jeong0449/FluidArdule/images/2026-06-15-fluidardule-collage.png

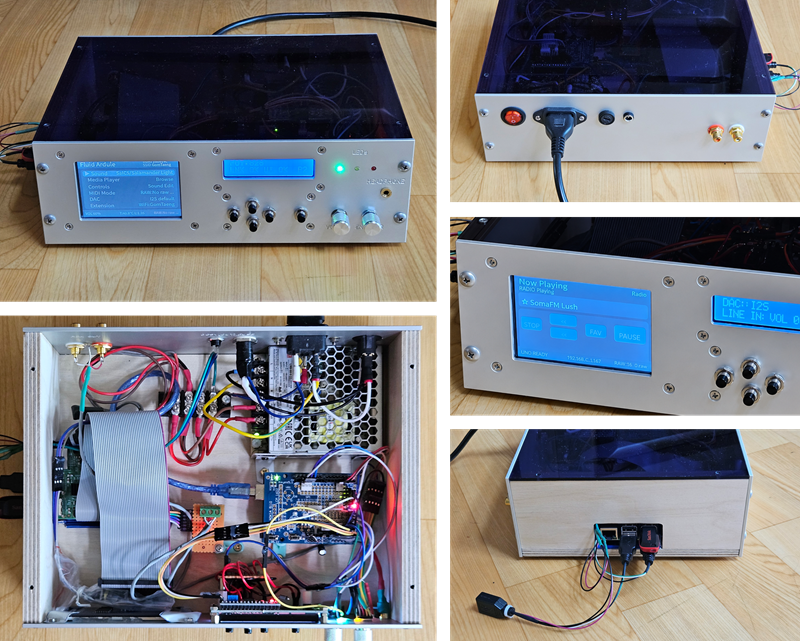
images/2026-06-15-fluidardule-collage.png
