jeong0449/FluidArdule/sf2/FluidArdule_rot.png

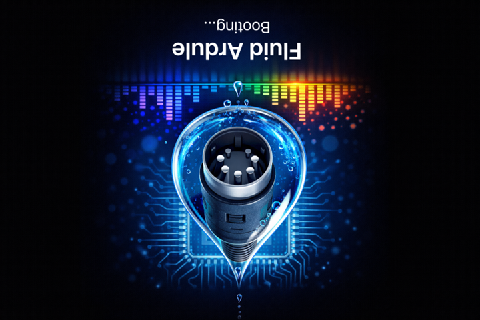
sf2/FluidArdule_rot.png
