jeong0449/FluidArdule/scripts/launch_fluidardule.py

#!/usr/bin/env python3
# -*- coding: utf-8 -*-

SCRIPT_VERSION = "260925a"

# =========================================================
# Fluid Ardule main UI/runtime script
# 260925a: Give resident Salamander C5 Lite a CH1-only Reverb default of 80;
#          show the last selected Sound Edit parameter/value on Home > Controls.
# 260924a: Standardize stacked transport navigation: NEXT above PREV in
#          Now Playing and Play with Drums; align player button actions accordingly.
# 260910e: Sound menu is a CH1 source selector again. The title bar shows
# CH2-16 resident SoundFont status at right; it dims while Yoshimi is active.
# 260910b: resident Salamander + GM SoundFont retained; Yoshimi uses reliable
#          exclusive engine handoff and restores the previous CH1 sound on return.
# Version is defined by SCRIPT_VERSION below.
# Detailed change history is tracked in Git.
# =========================================================

import os
import sys
import time
import queue
import signal
import threading
import subprocess
import re
import json
from pathlib import Path
from dataclasses import dataclass, field

import serial

try:
    from PIL import Image, ImageDraw, ImageFont, ImageChops
except Exception as exc:
    raise SystemExit(f"Pillow import failed: {exc}")



# =========================================================
# User config
# =========================================================

SERIAL_PORT = "/dev/serial/by-id/usb-Arduino__www.arduino.cc__Arduino_Uno_12724551266415469650-if00"
# Optional exact UNO-2 identifier.  If set, MIDI Mode shows
# "UNO-2 bridge (SEQ)" only when this by-id symlink exists.  Leave empty to
# fall back to detecting any additional Arduino/Uno serial device other than
# UNO-1.
UNO2_SERIAL_PORT = "/dev/serial/by-id/usb-Arduino__www.arduino.cc__0043_75834353930351211140-if00"
SERIAL_BAUD = 115200
SERIAL_TIMEOUT = 0.1
SERIAL_INPUT_IGNORE_AFTER_OPEN_SEC = 1.5
SERIAL_OUTPUT_HOLDOFF_AFTER_OPEN_SEC = 2.0

SOUNDFONTS = [
    ("/home/pi/sf2/SalC5Light2.sf2", "SalC5"),
    ("/home/pi/sf2/FluidR3_GM.sf2", "FluidR3"),
    ("/home/pi/sf2/Arachno_GM.sf2", "Arachno"),
    ("/home/pi/sf2/GeneralUser_GS.sf2", "GUserGS"),
    # Yoshimi is exposed through the same SoundFont menu as a synth-engine source.
    # The JSON file should follow Fluid Ardule instrument-list v2 and contain
    # Yoshimi .xiz entries grouped by bank_name.
    ("/home/pi/sf2/yoshimi.patches.json", "Yoshimi"),
]

# 260910a resident sound architecture
PIANO_SOUNDFONT_BASENAME = "SalC5Light2.sf2"
GM_SOUNDFONT_CHOICES = ["Arachno_GM.sf2", "FluidR3_GM.sf2", "GeneralUser_GS.sf2"]
GM_SOUNDFONT_STATE_PATH = "/home/pi/sf2/default_gm_soundfont.txt"
DEFAULT_GM_SOUNDFONT_BASENAME = "Arachno_GM.sf2"
RESIDENT_PIANO_SFID = 1
RESIDENT_GM_SFID = 2


YOSHIMI_EXECUTABLE = "yoshimi"
YOSHIMI_DEFAULT_ROOT = "/usr/share/yoshimi/banks"
YOSHIMI_PREVIEW_DEBOUNCE_SEC = 0.15
# Experimental restart-free Yoshimi instrument switching.
# When Yoshimi is already running, Fluid Ardule tries to keep the process alive
# and sends "load instrument <path>" through Yoshimi stdin.  The Yoshimi JSON
# should use space-free symlink paths because the Yoshimi CLI is fragile with
# filenames containing spaces.  If live loading is unavailable, the code falls
# back to the previous reliable restart-with -L path.
YOSHIMI_LIVE_LOAD_ENABLED = True
YOSHIMI_LIVE_LOAD_FALLBACK_RESTART = True
YOSHIMI_LIVE_LOAD_TRACE = False

# Yoshimi factory "Arpeggios" patches are not MIDI arpeggiators.
# Arpeggio1-like patches get their apparent repeat speed mainly from
# Part 1 / Effect 2 / Echo Delay.  The user-facing number below is calibrated
# to feel close to real BPM, then converted to Yoshimi Echo Delay.
ARP_BPM_DEFAULT = 120
ARP_BPM_MIN = 60
ARP_BPM_MAX = 240
ARP_BPM_STEP = 1
ARP_BPM_FINE_STEP = 1
ARP_CAL_SLOPE = 0.797
ARP_CAL_INTERCEPT = 5.13
ARP_DELAY_NUMERATOR = 6000


DEFAULT_DAC = ("default", "I2S default")
KNOWN_USB_DACS = [
    ("O22", "Onyx O22"),
    ("SCD70", "Roland SC-D70"),
    ("CODEC", "USB Audio CODEC"),
]

FLUID_GAIN = "0.4"

# Raw MIDI input selection
# 1) If RAW_MIDI_DEVICE is set, it is used directly.
# 2) Otherwise, if FIXED_MIDI_SRC is set, the first amidi -l entry whose name contains it is used.
# 3) Otherwise, preferred-name hints are tried, then the first usable raw MIDI input is used.
RAW_MIDI_DEVICE = None               # e.g. "hw:1,0,0"
RAW_MIDI_PREFERRED_HINTS = [
    "MPK Mini",
    "AKAI",
    "Keyboard",
]

# External USB MIDI interface selection.
# Match by device/client name instead of ALSA client number because client IDs
# can change across reboots or USB hotplug order changes.
EXTERNAL_MIDI_NAME_HINTS = [
    "USB Midi Cable",
    "SC-D70",
    "SCD70",
    "Roland SC-D70",
]

# Some external sound modules expose ALSA sequencer ports in both aconnect -i
# and aconnect -o. For MIDI Mode, keep only ports that can be meaningful
# performance inputs. USB MIDI cables remain visible because their DIN IN side
# can carry keyboard input; for SC-D70, show only the generic "SC-D70 MIDI"
# port and hide Part A/B, which are sound-module destinations.
SEQ_INPUT_ALLOW_EXTERNAL_HINTS = [
    "USB Midi Cable",
]
SEQ_INPUT_EXCLUDE_EXTERNAL_HINTS = [
    "SC-D70",
    "SCD70",
    "Roland SC-D70",
]
EXTERNAL_MIDI_OUT_MODES = [
    ("off", "Off"),
    ("mirror", "Mirror"),
]
EXTERNAL_MIDI_PC_PREVIEW_DEBOUNCE_SEC = 0.15

# General MIDI program names. Displayed as 001-128, sent as MIDI PC 0-127.
GM_PROGRAM_NAMES = [
    "Acoustic Grand Piano", "Bright Acoustic Piano", "Electric Grand Piano", "Honky-tonk Piano",
    "Electric Piano 1", "Electric Piano 2", "Harpsichord", "Clavi",
    "Celesta", "Glockenspiel", "Music Box", "Vibraphone",
    "Marimba", "Xylophone", "Tubular Bells", "Dulcimer",
    "Drawbar Organ", "Percussive Organ", "Rock Organ", "Church Organ",
    "Reed Organ", "Accordion", "Harmonica", "Tango Accordion",
    "Acoustic Guitar (nylon)", "Acoustic Guitar (steel)", "Electric Guitar (jazz)", "Electric Guitar (clean)",
    "Electric Guitar (muted)", "Overdriven Guitar", "Distortion Guitar", "Guitar harmonics",
    "Acoustic Bass", "Electric Bass (finger)", "Electric Bass (pick)", "Fretless Bass",
    "Slap Bass 1", "Slap Bass 2", "Synth Bass 1", "Synth Bass 2",
    "Violin", "Viola", "Cello", "Contrabass",
    "Tremolo Strings", "Pizzicato Strings", "Orchestral Harp", "Timpani",
    "String Ensemble 1", "String Ensemble 2", "SynthStrings 1", "SynthStrings 2",
    "Choir Aahs", "Voice Oohs", "Synth Voice", "Orchestra Hit",
    "Trumpet", "Trombone", "Tuba", "Muted Trumpet",
    "French Horn", "Brass Section", "SynthBrass 1", "SynthBrass 2",
    "Soprano Sax", "Alto Sax", "Tenor Sax", "Baritone Sax",
    "Oboe", "English Horn", "Bassoon", "Clarinet",
    "Piccolo", "Flute", "Recorder", "Pan Flute",
    "Blown Bottle", "Shakuhachi", "Whistle", "Ocarina",
    "Lead 1 (square)", "Lead 2 (sawtooth)", "Lead 3 (calliope)", "Lead 4 (chiff)",
    "Lead 5 (charang)", "Lead 6 (voice)", "Lead 7 (fifths)", "Lead 8 (bass + lead)",
    "Pad 1 (new age)", "Pad 2 (warm)", "Pad 3 (polysynth)", "Pad 4 (choir)",
    "Pad 5 (bowed)", "Pad 6 (metallic)", "Pad 7 (halo)", "Pad 8 (sweep)",
    "FX 1 (rain)", "FX 2 (soundtrack)", "FX 3 (crystal)", "FX 4 (atmosphere)",
    "FX 5 (brightness)", "FX 6 (goblins)", "FX 7 (echoes)", "FX 8 (sci-fi)",
    "Sitar", "Banjo", "Shamisen", "Koto",
    "Kalimba", "Bag pipe", "Fiddle", "Shanai",
    "Tinkle Bell", "Agogo", "Steel Drums", "Woodblock",
    "Taiko Drum", "Melodic Tom", "Synth Drum", "Reverse Cymbal",
    "Guitar Fret Noise", "Breath Noise", "Seashore", "Bird Tweet",
    "Telephone Ring", "Helicopter", "Applause", "Gunshot",
]

def gm_program_label(index: int) -> str:
    index = max(0, min(127, int(index)))
    return f"{index + 1:03d} {GM_PROGRAM_NAMES[index]}"


def gm_category_index_for_program(index: int) -> int:
    return max(0, min(15, int(index) // 8))


def gm_category_base(category_index: int) -> int:
    return max(0, min(15, int(category_index))) * 8


def gm_current_category_name() -> str:
    return GM_CATEGORY_NAMES[gm_category_index_for_program(state.external_midi_pc_index)]


def gm_current_category_program_indices() -> list[int]:
    base = gm_category_base(gm_category_index_for_program(state.external_midi_pc_index))
    return list(range(base, min(base + 8, len(GM_PROGRAM_NAMES))))
BRIDGE_EXECUTABLE = "/home/pi/bin/uno_midi_bridge_sp"
BRIDGE_PORT_HINT = "UNO-bridge"
BRIDGE_AUTOSTART = False
FIXED_MIDI_SRC = None
LOG_DIR = "/home/pi/log/fluidardule"
FLUID_LOG_PATH = f"{LOG_DIR}/fluidsynth.log"
PLAYER_LOG_PATH = f"{LOG_DIR}/player.log"
BLUETOOTH_APLAY_EXECUTABLE = "bluealsa-aplay"
YOSHIMI_LOG_PATH = f"{LOG_DIR}/yoshimi.log"
AMIXER_CONTROL = "PCM"
# Do not force ALSA mixer to 100% at service start.
# The first POT report from UNO-1, or the last saved pot-derived volume, owns startup volume.
FIX_VOLUME_AT_100 = False
POT_VOLUME_ENABLED = True
VOLUME_STATE_PATH = "/tmp/fluidardule_last_volume_percent"
DEFAULT_STARTUP_VOLUME_PERCENT = 85
BLUETOOTH_OUTPUT_VOLUME_PERCENT = 95
# At startup the saved/default volume is only a temporary safety value.
# The physical POT position should own the real startup volume as soon as
# UNO-1 is ready.  Some firmware builds report POT only on movement, so the
# Pi asks for a short POT snapshot window after serial connection.
POT_STARTUP_SNAPSHOT_REQUEST_SEC = 5.0
POT_STARTUP_SNAPSHOT_REQUEST_INTERVAL_SEC = 0.5
DEVICE_POLL_INTERVAL_SEC = 3.0
BLUETOOTH_STATUS_POLL_INTERVAL_SEC = 1.0
MIDI_RECONNECT_STABLE_SEC = 1.5
SERIAL_HEARTBEAT_INTERVAL_SEC = 1.0
SERIAL_UI_STATUS_INTERVAL_SEC = 1.0
SERIAL_LINK_STALE_SEC = 3.0
LED_PULSE_COOLDOWN_SEC = 0.05
POT_LED_PULSE_INTERVAL_SEC = 0.07
POT_VOLUME_PERCENT_THRESHOLD = 3
POT_LED_PERCENT_THRESHOLD = 3
SYSTEM_STATUS_POLL_INTERVAL_SEC = 10.0
BRIDGE_WATCHDOG_INTERVAL_SEC = 2.0
SERIAL_MAX_CONSEC_WRITE_ERRORS = 3
SERIAL_MAX_CONSEC_READ_ERRORS = 5
SERIAL_REOPEN_COOLDOWN_SEC = 3.0
MIDI_ACTIVITY_MONITOR_ENABLED = True
MIDI_ACTIVITY_MONITOR_POLL_SEC = 1.0


FRAMEBUFFER_DEVICE = "/dev/fb1"
FRAMEBUFFER_SYS_DIR = "/sys/class/graphics/fb1"
FALLBACK_WIDTH = 480
FALLBACK_HEIGHT = 320
BACKGROUND = (10, 12, 18)
FG = (240, 240, 240)
DIM = (160, 170, 180)
ACCENT = (100, 190, 255)
SELECT_BG = (45, 70, 110)
BOX_BG = (20, 24, 32)
STATUS_GOOD = (90, 220, 120)
STATUS_BAD = (255, 110, 110)
MODIFIED_VALUE = (255, 220, 90)
# Minimum interval between TFT renders (in seconds).
# Frequent screen updates can interfere with real-time audio on Raspberry Pi,
# causing jitter or glitches during MIDI playback.
# Increasing this value improves audio stability at the cost of UI responsiveness.
RENDER_MIN_INTERVAL = 0.10
# Diagnostic result 2026-06-20: continuous TFT rendering on Raspberry Pi 3B
# can disturb Yoshimi real-time audio. Keep normal UI responsiveness for
# FluidSynth/media, but throttle background redraws while Yoshimi is active.
YOSHIMI_RENDER_MIN_INTERVAL = 1.00
COMBI_RENDER_MIN_INTERVAL = 1.00
# During early boot, the framebuffer can be overwritten by late-starting
# splash/console components after the Python UI has already drawn Home.
# Force occasional full redraws only during this short boot window so the
# screen recovers from any external overwrite without increasing steady-state
# TFT update load.
BOOT_FULL_REDRAW_SEC = 8.0
BOOT_FULL_REDRAW_INTERVAL_SEC = 0.75
ROTATE_180 = True

FONT_CANDIDATES = [
    "/usr/share/fonts/opentype/noto/NotoSansCJK-Regular.ttc",
    "/usr/share/fonts/opentype/noto/NotoSerifCJK-Regular.ttc",
    "/usr/share/fonts/truetype/dejavu/DejaVuSans.ttf",
    "/usr/share/fonts/truetype/liberation2/LiberationSans-Regular.ttf",
    "/usr/share/fonts/truetype/noto/NotoSans-Regular.ttf",
]

# Rename editor only: fixed-width text keeps the cursor aligned with characters.
MONO_FONT_CANDIDATES = [
    "/usr/share/fonts/truetype/dejavu/DejaVuSansMono.ttf",
    "/usr/share/fonts/truetype/liberation2/LiberationMono-Regular.ttf",
    "/usr/share/fonts/truetype/noto/NotoSansMono-Regular.ttf",
]

MAIN_MENU = [
    "Sound",
    "Media Player",
    "Controls",
    "MIDI Mode",
    "DAC",
    "Extension",
]

QUICK_MENU_ITEMS = [
    "MIDI Panic",
    "Home",
    "Now Playing",
    "Sound",
    "Play with Drums",
    "USB Eject",
    "Save User Preset",
    "Arpeggio Speed",
]

FILE_ROOT_CANDIDATES = [
    "/home/pi/media",
    "/home/pi/midi",
    "/home/pi/Music",
    "/home/pi",
]

EXT_TAG = {
    ".mid": "[MID]",
    ".midi": "[MID]",
    ".wav": "[WAV]",
    ".mp3": "[MP3]",
    ".ogg": "[OGG]",
    ".wma": "[WMA]",
}

PLAYABLE_EXTS = tuple(EXT_TAG.keys())
AUDIO_FILE_EXTS = (".wav", ".mp3", ".ogg", ".wma")

FILE_MEDIA_ROOT = "/home/pi/media"
USB_MOUNT_POINT = f"{FILE_MEDIA_ROOT}/usb"
USB_STATUS_POLL_INTERVAL_SEC = 1.0
USB_EJECT_CMD = ["sudo", "-n", "/bin/umount", USB_MOUNT_POINT]
USB_LABEL = "USB"

USER_PRESET_PATH = "/home/pi/sf2/user_presets.json"
USER_COMBI_PATH = "/home/pi/sf2/user_combis.json"
COMBI_SOUNDFONT_OPTIONS = [
    ("FluidR3_GM", "FluidR3_GM.sf2"),
    ("GeneralUser_GS", "GeneralUser_GS.sf2"),
    ("Arachno_GM", "Arachno_GM.sf2"),
]
COMBI_SOUNDFONT_LABEL_COLOR = (80, 175, 235)
COMBI_INPUT_CHANNEL = 1
COMBI_PREVIEW_FOOTER_HOLD_SEC = 1.5
USER_PRESET_PREVIEW_ON_HIGHLIGHT = True
# Delay User Preset preview while scrolling so only the final highlighted item loads.
USER_PRESET_PREVIEW_DEBOUNCE_SEC = 0.45
# Larger SF2 files need a little more settling time after FluidSynth starts.
FLUIDSYNTH_STARTUP_SETTLE_DEFAULT_SEC = 1.2
FLUIDSYNTH_STARTUP_SETTLE_LARGE_SEC = 2.4
FLUIDSYNTH_LARGE_SF2_NAMES = {"FluidR3_GM.sf2", "GeneralUser_GS.sf2"}

RADIO_STATIONS_PATH = "/home/pi/sf2/radio_stations.json"
RADIO_FAVORITES_PATH = "/home/pi/sf2/radio_favorites.json"

# ADP v2.3 Final drum-pattern playback (Quick Menu > Play with Drums).
# Runtime support is intentionally ADP-only and ORN is ignored. Registered slot
# maps and the 6-accent representative velocities are resolved from JSON files
# kept beside the SoundFonts. INLINE slot maps (ID 255) are not used by this
# minimal runtime because they require parsing a companion ADT file.
ADP_PATTERN_DIR = "/home/pi/sf2/ADP"
ADP_SLOT_MAP_PATH = "/home/pi/sf2/slot_map_definitions.json"
ADP_ACCENT_LEVELS_PATH = "/home/pi/sf2/accent_levels.json"
ADP_DEFAULT_BPM = 120
ADP_DEFAULT_DRUM_VOLUME_PERCENT = 85
ADP_NOTE_LENGTH_SEC = 0.040
ADP_TAP_MIN_BPM = 40
ADP_TAP_MAX_BPM = 300
ADP_TAP_HISTORY = 5
ADP_TAP_HIHAT_NOTE = 42
ADP_TAP_HIHAT_VELOCITY = 105
ADP_TAP_HIHAT_LENGTH_SEC = 0.035
ADP_GENRES = [
    ("RCK", "Rock"),
    ("BNV", "Bossa Nova"),
    ("FNK", "Funk"),
    ("JZZ", "Jazz"),
    ("BLU", "Blues"),
    ("POP", "Pop"),
    ("BAL", "Ballad"),
    ("LAT", "Latin"),
    ("AFC", "Afro-Cuban"),
    ("SMB", "Samba"),
    ("WLZ", "Waltz"),
    ("SWG", "Swing"),
    ("SHF", "Shuffle"),
    ("REG", "Reggae"),
    ("MTL", "Metal"),
    ("HHP", "Hip-Hop"),
    ("RNB", "R&B"),
    ("EDM", "EDM"),
    ("HSE", "House"),
    ("TNO", "Techno"),
    ("DRM", "Drums"),
]
ADP_GENRE_NAME = dict(ADP_GENRES)
ADP_FIELD_NAMES = ("genre", "pattern", "kit")

WIFI_INTERFACE = "wlan0"
WPA_SUPPLICANT_CONF = "/etc/wpa_supplicant/wpa_supplicant-wlan0.conf"
WPA_SUPPLICANT_CONF_FALLBACK = "/etc/wpa_supplicant/wpa_supplicant.conf"
WIFI_SELECTED_PRIORITY = 50
WIFI_OTHER_PRIORITY = 10
# Cache Wi-Fi status/config reads to avoid repeated sudo cat during UI redraws.
WIFI_STATUS_CACHE_SEC = 10.0
WIFI_KNOWN_SSIDS_CACHE_SEC = 180.0
WIFI_SCAN_TIMEOUT_SEC = 8.0


DEFAULT_RADIO_STATIONS = [
    {"id": "somafm_groovesalad", "name": "SomaFM Groove Salad", "url": "https://ice2.somafm.com/groovesalad-128-mp3"},
    {"id": "somafm_dronezone", "name": "SomaFM Drone Zone", "url": "https://ice2.somafm.com/dronezone-128-mp3"},
    {"id": "somafm_defcon", "name": "SomaFM DEF CON", "url": "https://ice2.somafm.com/defcon-128-mp3"},
    {"id": "jazz24", "name": "Jazz24", "url": "https://live.wostreaming.net/direct/ppm-jazz24mp3-ibc1"},
    {"id": "somafm_secretagent", "name": "SomaFM Secret Agent", "url": "https://ice2.somafm.com/secretagent-128-mp3"},
    {"id": "somafm_lush", "name": "SomaFM Lush", "url": "https://ice2.somafm.com/lush-128-mp3"},
    {"id": "somafm_u80s", "name": "SomaFM Underground 80s", "url": "https://ice2.somafm.com/u80s-128-mp3"},
    {"id": "somafm_beatblender", "name": "SomaFM Beat Blender", "url": "https://ice2.somafm.com/beatblender-128-mp3"},
    {"id": "somafm_illstreet", "name": "SomaFM Illinois Street Lounge", "url": "https://ice2.somafm.com/illstreet-128-mp3"},
    {"id": "somafm_cliqhop", "name": "SomaFM Cliqhop", "url": "https://ice2.somafm.com/cliqhop-128-mp3"},
    {"id": "somafm_folkfwd", "name": "SomaFM Folk Forward", "url": "https://ice2.somafm.com/folkfwd-128-mp3"},
    {"id": "somafm_metal", "name": "SomaFM Metal Detector", "url": "https://ice2.somafm.com/metal-128-mp3"},
]
USER_PRESET_RENAME_CHARS = " ABCDEFGHIJKLMNOPQRSTUVWXYZabcdefghijklmnopqrstuvwxyz0123456789-_.,()"
USER_PRESET_RENAME_MAX_LEN = 32

POWER_MENU_ITEMS = ["Halt", "Restart Software", "Console", "Reboot"]
POWER_CONFIRM_ITEMS = ["No", "Yes"]
FLUID_ARDULE_SERVICE = "fluid_ardule.service"
RESTART_SOFTWARE_MARKER = "/tmp/fluidardule_restart_software_pending"
CONSOLE_HELPER = "/usr/local/sbin/fluidardule-console"

# Sound Edit is a volatile, non-saving performance edit page.
# CC7 Volume is intentionally excluded because the hardware pot controls volume.
SALAMANDER_REVERB_DEFAULT = 80

SOUND_EDIT_PARAMS = [
    {"label": "Expression", "name": "Expression", "cc": 11, "default": 127},
    {"label": "Modulation", "name": "Modulation", "cc": 1,  "default": 0},
    {"label": "Reverb",     "name": "Reverb",     "cc": 91, "default": 40},
    {"label": "Chorus",     "name": "Chorus",     "cc": 93, "default": 0},
    {"label": "Brightness", "name": "Brightness", "cc": 74, "default": 64},
    {"label": "Resonance",  "name": "Resonance",  "cc": 71, "default": 64},
    {"label": "Pan",        "name": "Pan",        "cc": 10, "default": 64},
    {"label": "Attack",     "name": "Attack",     "cc": 73, "default": 64},
]
SOUND_EDIT_COLS = 2
SOUND_EDIT_MIN = 0
SOUND_EDIT_MAX = 127
SOUND_EDIT_STEP = 1
# UNO-1 firmware owns low-level encoder acceleration and reports its profile via ACCEL.
# Python interprets encoder input differently depending on context:
#   - menu/list navigation: use the signed ENC magnitude from UNO as row delta
#   - Sound Edit value editing: use the signed ENC magnitude from UNO and scale it
#     non-linearly according to the current UNO acceleration profile
SOUND_EDIT_SEND_ALL_CHANNELS = True
# Keep the debug logging hooks in the code, but leave them disabled for normal use.
# Set this to True temporarily when verifying CC transmission with journalctl.
SOUND_EDIT_CC_DEBUG = False
# Encoder trace diagnostics. Enable this temporarily while running the script
# from a terminal (not as a systemd service) to see every ENC event received
# from UNO-1 and the resulting UI/value movement. Keep False for normal use.
ENCODER_TRACE = False
# Encoder acceleration profile sync diagnostics. Enable temporarily to see
# Pi -> UNO ACCELSET:n decisions when UI context changes or serial reconnects.
ACCEL_PROFILE_TRACE = True
# If True, ACCEL:n reports from UNO-1 also produce a short TFT footer message.
# Keep False for normal context-specific profile switching because UNO LCD
# already shows the active P0/P1/P2/P3 profile.
ACCEL_PROFILE_TFT_FEEDBACK = False
ENCODER_ACCEL_DEFAULT_PROFILE = 0
ENCODER_ACCEL_OPTIONS = {
    0: "P0 Precise",
    1: "P1 Fine",
    2: "P2 Normal",
    3: "P3 Fast",
}
# Pi-side default acceleration policy. UNO-1 still applies the acceleration,
# but Raspberry Pi selects the suitable profile for the current UI context.
# Long-list navigation gets P1; precise top-level/menu screens get P0;
# continuous/value editing gets P2. Unknown contexts fall back to P0.
UI_ACCEL_PROFILE_DEFAULT = 0
UI_ACCEL_PROFILE_BY_CONTEXT = {
    "main": 0,
    "file_source": 0,
    "file_browser": 1,
    "radio_browser": 1,
    "quick_menu": 0,
    "play_with_drums": 2,
    "adp_tap_tempo": 0,
    "player": 0,
    "power_menu": 0,
    "restart_wait": 0,
    "sound_edit": 2,
    "submenu:preset": 1,
    "submenu:preset_category": 1,
    "submenu:user_preset_load": 1,
    "submenu:combi_load": 1,
    "submenu:combi_detail": 1,
    "submenu:external_midi_pc": 1,
    "submenu:arp_speed": 2,
    "submenu:gm_soundfont": 0,
    "submenu:user_preset_rename": 0,
}
# Navigation jitter guard for the rotary encoder.
# UNO-1 can occasionally emit a single opposite-direction ENC event when the
# knob is turned slowly near a detent. For menu navigation, that one event is
# very visible as a wrong one-row jump, so Python ignores only a very short
# opposite-direction pulse. Sound Edit value editing is not filtered here.
ENC_NAV_REVERSAL_GUARD_SEC = 0.12
POT_MODE_DEFAULT = "VOL"
POT_MODE_FOOTER_HOLD_SEC = 1.2
ACCEL_FOOTER_HOLD_SEC = 1.2
FOOTER_ALT_INTERVAL_SEC = 2.0
VOLUME_FOOTER_HOLD_SEC = 1.8
# Soft takeover threshold for returning the physical pot to volume control.
# When POT mode switches back from PARAM to VOL, the volume is not updated
# until the physical pot position comes close to the current logical volume.
# This prevents abrupt volume jumps caused by the pot angle being reused for CC editing.
POT_VOLUME_PICKUP_THRESHOLD = 3


def default_sound_edit_values() -> dict[int, int]:
    return {int(item["cc"]): int(item["default"]) for item in SOUND_EDIT_PARAMS}


# =========================================================
# Runtime state
# =========================================================

@dataclass
class RuntimeState:
    running: bool = True

    sf_index: int = 0
    sf_name: str = ""
    gm_soundfont_basename: str = DEFAULT_GM_SOUNDFONT_BASENAME
    fluidsynth_muted: bool = False
    current_preset_bank: int = 0
    current_preset_program: int = 0
    current_preset_name: str = "Piano"
    current_engine: str = "fluidsynth"
    current_instrument_path: str | None = None
    # Snapshot of the FluidSynth CH1 sound before entering Yoshimi.
    yoshimi_restore_sf_index: int | None = None
    yoshimi_restore_bank: int = 0
    yoshimi_restore_program: int = 0
    yoshimi_restore_name: str = "Piano"

    dac_index: int = 0
    dac_name: str = DEFAULT_DAC[1]
    audio_device: str = DEFAULT_DAC[0]
    dac_options: list[tuple[str, str]] = field(default_factory=lambda: [DEFAULT_DAC])
    dac_preview_index: int = 0

    midi_mode: str = "usb_direct_raw"
    midi_mode_options: list[tuple[str, str]] = field(default_factory=lambda: [
        ("usb_direct_raw", "USB direct RAW"),
    ])
    bridge_proc: subprocess.Popen | None = None
    bridge_running: bool = False
    bridge_port_name: str = BRIDGE_PORT_HINT
    midi_display_text: str = "RAW"
    selected_alsa_input: str | None = None
    selected_alsa_input_name: str | None = None
    preferred_seq_port: str | None = None
    preferred_seq_name: str | None = None

    external_midi_out_mode: str = "off"
    external_midi_present: bool = False
    external_midi_port: str | None = None
    external_midi_name: str | None = None
    preferred_external_midi_port: str | None = None
    preferred_external_midi_name: str | None = None
    external_midi_connected: bool = False
    external_midi_pc_index: int = 0
    external_midi_pc_channel: int = 1
    arp_bpm: int = ARP_BPM_DEFAULT
    pending_external_midi_pc_index: int | None = None
    pending_external_midi_pc_due: float = 0.0

    midi_selected_name: str | None = None
    midi_options: list[tuple[str, str]] = field(default_factory=list)
    midi_src_name: str = "none"
    midi_src_port: str = "-"
    fluid_dst_port: str = "-"
    midi_connected: bool = False
    midi_pending_signature: str = ""
    midi_candidate_seen_since: float = 0.0

    fluid_pid: int | None = None
    last_event: str = "-"
    last_device_poll_time: float = 0.0
    last_render_time: float = 0.0
    dirty: bool = True
    force_full_redraw_until: float = 0.0
    last_forced_full_redraw_time: float = 0.0
    last_yoshimi_render_time: float = 0.0

    ui_mode: str = "main"      # main / submenu / file_source / file_browser / player
    menu_index: int = 0
    submenu_index: int = 0
    submenu_key: str | None = None
    # Sound submenu has two in-row choices for SoundFont/User Preset rows:
    # 0 = Default, 1 = Presets. RIGHT switches focus; SELECT chooses it.
    sound_row_focus: int = 0
    preset_entries: list[dict] = field(default_factory=list)
    preset_index: int = 0
    preset_sf_index: int | None = None
    preset_source_name: str = ""
    category_entries: list[str] = field(default_factory=list)
    category_index: int = 0
    category_source_sf_index: int | None = None
    category_source_name: str = ""
    preview_active: bool = False
    preview_restore_sf_index: int | None = None
    preview_restore_preset_bank: int = 0
    preview_restore_preset_program: int = 0
    preview_restore_preset_name: str = ""
    preview_restore_engine: str = "fluidsynth"
    preview_restore_instrument_path: str | None = None
    pending_yoshimi_preview_index: int | None = None
    pending_yoshimi_preview_due: float = 0.0

    browser_root: str = FILE_MEDIA_ROOT
    browser_path: str = FILE_MEDIA_ROOT
    browser_entries: list[dict] = field(default_factory=list)
    browser_index: int = 0
    radio_entries: list[dict] = field(default_factory=list)
    radio_index: int = 0
    radio_view_mode: str = "all"   # all / favorites

    wifi_enabled: bool = True
    wifi_current_ssid: str = ""
    wifi_ipv4_address: str = ""
    wifi_scan_results: list[str] = field(default_factory=list)
    wifi_known_ssids: list[str] = field(default_factory=list)


    player_proc_kind: str | None = None   # engine / media
    player_path: str | None = None
    player_paused: bool = False
    player_status: str = "Stopped"

    prev_ui_mode: str = "main"
    submenu_return_mode: str | None = None
    power_menu_index: int = 0
    power_confirm_action: str | None = None
    power_confirm_index: int = 0

    quick_menu_index: int = 0
    quick_resume_snapshot: dict | None = None

    sound_edit_index: int = 0
    sound_edit_values: dict[int, int] = field(default_factory=default_sound_edit_values)
    sound_edit_a_values: dict[int, int] = field(default_factory=default_sound_edit_values)
    sound_edit_active_side: str = "B"
    sound_edit_modified: set[int] = field(default_factory=set)
    sound_edit_last_adjust_time: float = 0.0
    encoder_accel_profile: int = ENCODER_ACCEL_DEFAULT_PROFILE
    encoder_accel_pending_profile: int = ENCODER_ACCEL_DEFAULT_PROFILE
    last_nav_enc_dir: int = 0
    last_nav_enc_time: float = 0.0
    pot_mode: str = POT_MODE_DEFAULT
    pot_volume_captured: bool = True
    transient_footer_text: str = ""
    transient_footer_until: float = 0.0

    volume_percent: int = 100
    last_volume_display_time: float = 0.0
    last_footer_alt_slot: int = -1
    last_pot_raw: int = -1
    initial_pot_volume_applied: bool = False
    pot_startup_request_until: float = 0.0
    last_pot_startup_request_time: float = 0.0
    last_led_pulse_time: float = 0.0
    last_pot_led_pulse_time: float = 0.0
    last_pot_led_percent: int = -1

    cpu_load_text: str = "L:-"
    cpu_temp_text: str = "T:-"
    last_system_status_poll_time: float = 0.0
    last_bridge_poll_time: float = 0.0

    usb_mounted: bool = False
    last_usb_poll_time: float = 0.0
    last_usb_autoenter_time: float = 0.0
    usb_mount_path: str = USB_MOUNT_POINT
    usb_eject_confirm: bool = False

    player_stop_requested: bool = False
    player_auto_next: bool = True
    player_origin_dir: str | None = None
    player_return_mode: str | None = None  # file_browser / radio_browser
    player_radio_station_id: str | None = None
    player_notice_text: str = ""
    player_notice_until: float = 0.0
    last_bluetooth_status_poll_time: float = 0.0
    bluetooth_stop_return_at: float = 0.0
    bluetooth_saved_volume_percent: int | None = None
    bluetooth_volume_override_active: bool = False

    adp_path: str | None = None
    adp_name: str = "No ADP pattern"
    adp_grid_code: int = 0
    adp_slot_map_id: int = 0
    adp_slot_notes: list[int] = field(default_factory=list)
    adp_accent_velocities: list[int] = field(default_factory=list)
    adp_steps: list[list[tuple[int, int]]] = field(default_factory=list)
    adp_bpm: int = ADP_DEFAULT_BPM
    adp_drum_volume_percent: int = ADP_DEFAULT_DRUM_VOLUME_PERCENT
    adp_drum_volume_captured: bool = False
    adp_playing: bool = False
    adp_error: str = ""
    adp_drum_kits: list[dict] = field(default_factory=list)
    adp_drum_kit_index: int = 0
    adp_pending_drum_kit_index: int | None = None
    adp_patterns_by_genre: dict[str, list[str]] = field(default_factory=dict)
    adp_genre_codes: list[str] = field(default_factory=list)
    adp_genre_index: int = 0
    adp_pattern_index: int = 0
    adp_selected_field: int = 0
    adp_pending_pattern: dict | None = None
    adp_source_sf_name: str = ""
    adp_source_preset_name: str = ""
    adp_tap_times: list[float] = field(default_factory=list)
    adp_tap_measured_bpm: int | None = None
    adp_tap_original_bpm: int = ADP_DEFAULT_BPM
    adp_tap_resume_playback: bool = False
    adp_tap_route_disconnected: bool = False
    # RAW MIDI devices are normally opened directly by FluidSynth and cannot be
    # monitored concurrently by amidi.  Tap Tempo temporarily restarts
    # FluidSynth with the ALSA sequencer driver so Python can own the RAW device,
    # suppress the original key notes, and interpret every Note On as a tap.

    pending_resume_after_sf_apply: bool = False

    user_preset_entries: list[dict] = field(default_factory=list)
    user_preset_target_index: int = 0
    pending_user_preset_preview_index: int | None = None
    pending_user_preset_preview_due: float = 0.0
    previewed_user_preset_index: int | None = None
    user_preset_rename_text: str = ""
    user_preset_rename_cursor: int = 0
    current_user_preset_name: str | None = None
    current_user_preset_kind: str | None = None
    combi_entries: list[dict] = field(default_factory=list)
    combi_soundfont_index: int = 0
    current_combi_id: str | None = None
    current_combi_soundfont_key: str | None = None
    current_combi_name: str | None = None
    combi_active: bool = False
    combi_parts: list[dict] = field(default_factory=list)
    combi_input_channel: int = COMBI_INPUT_CHANNEL
    combi_router_signature: str = ""
    combi_preview_active: bool = False
    combi_browse_snapshot: dict | None = None
    previewed_combi_index: int | None = None
    modal_message: str = ""
    modal_submessage: str = ""
    modal_until: float = 0.0

    # Lightweight UI caches. Sound Source rendering should not repeatedly read
    # preset JSON files on every draw; cache counts and invalidate only when the
    # underlying User Preset list is changed.
    soundfont_count_cache: dict[int, tuple[int, int]] = field(default_factory=dict)
    user_preset_count_cache: int | None = None
    user_combi_count_cache: int | None = None
    sound_source_cache_preload_started: bool = False
    sound_source_cache_preload_done: bool = False

    # Ignore short burst of stale/noisy UI events after UNO-1 serial reconnect/reset.
    serial_input_ignore_until: float = 0.0


state = RuntimeState(sf_index=0, sf_name=SOUNDFONTS[0][1])
event_q: queue.Queue[str] = queue.Queue()
fluid_proc = None
yoshimi_proc = None
fluid_log_handle = None
yoshimi_log_handle = None
player_proc = None
player_ext_midi_proc = None
player_log_handle = None
serial_handle = None
last_enc_time = 0.0
serial_lock = threading.Lock()
last_serial_hb_time = 0.0
last_serial_ui_status_time = 0.0
last_serial_ui_status_sent = ""
serial_write_error_count = 0
serial_read_error_count = 0
midi_activity_proc = None
midi_activity_signature = ""
midi_activity_thread_handle = None
combi_router_proc = None
combi_router_thread_handle = None
combi_router_generation = 0
adp_play_thread = None
adp_stop_event = threading.Event()
_wifi_status_cache_until = 0.0
_wifi_known_ssids_cache_until = 0.0
_wifi_known_ssids_cache: list[str] = []
last_accel_context_key: str | None = None
last_sent_accel_profile: int | None = None



# =========================================================
# Common utils
# =========================================================

def log(msg: str) -> None:
    ts = time.strftime("%Y-%m-%d %H:%M:%S")
    print(f"[{ts}] {msg}", flush=True)


def mark_dirty(event: str | None = None) -> None:
    if event is not None:
        state.last_event = event
    state.dirty = True


def show_footer_message(text: str, hold_sec: float = 1.2) -> None:
    """Temporarily show a high-priority status message in the footer.

    Used for short-lived hardware mode changes such as encoder acceleration
    profile and POT mode. After the hold time expires, the normal footer
    content automatically returns on the next render tick.
    """
    state.transient_footer_text = text
    state.transient_footer_until = time.time() + float(hold_sec)
    mark_dirty(text)


def show_player_notice(text: str, hold_sec: float = 1.5) -> None:
    """Temporarily show a centered notice on the Now Playing screen."""
    state.player_notice_text = str(text or "")
    state.player_notice_until = time.time() + float(hold_sec)
    mark_dirty(state.player_notice_text)


def clamp_index(index: int, length: int) -> int:
    if length <= 0:
        return 0
    if index < 0:
        return 0
    if index >= length:
        return length - 1
    return index


def run_cmd(cmd: list[str] | str) -> tuple[int, str]:
    try:
        if isinstance(cmd, str):
            p = subprocess.run(cmd, shell=True, text=True, stdout=subprocess.PIPE, stderr=subprocess.STDOUT, check=False)
        else:
            p = subprocess.run(cmd, text=True, stdout=subprocess.PIPE, stderr=subprocess.STDOUT, check=False)
        return p.returncode, p.stdout.strip()
    except Exception as exc:
        return 1, str(exc)

def get_cpu_load_text() -> str:
    try:
        load1 = os.getloadavg()[0]
        return f"L:{load1:.2f}"
    except Exception:
        return "L:-"


def get_cpu_temp_text() -> str:
    degree = "\u00B0"
    try:
        code, out = run_cmd(["vcgencmd", "measure_temp"])
        if code == 0 and "temp=" in out:
            value = out.split("temp=", 1)[1].split("'", 1)[0].strip()
            return f"T:{value}{degree}C"
    except Exception:
        pass
    try:
        raw = Path('/sys/class/thermal/thermal_zone0/temp').read_text().strip()
        return f"T:{int(raw)/1000:.1f}{degree}C"
    except Exception:
        return "T:-"


def periodic_system_status_poll() -> None:
    now = time.time()
    if now - state.last_system_status_poll_time < SYSTEM_STATUS_POLL_INTERVAL_SEC:
        return
    state.last_system_status_poll_time = now
    new_load = get_cpu_load_text()
    new_temp = get_cpu_temp_text()
    if new_load != state.cpu_load_text or new_temp != state.cpu_temp_text:
        state.cpu_load_text = new_load
        state.cpu_temp_text = new_temp
        state.dirty = True


def refresh_status_once(event: str = "Status refreshed") -> None:
    """Refresh slow-changing system/device status only on explicit user request.

    Fluid Ardule is now event-driven: normal button/encoder/POT events redraw the
    current screen, but they do not poll slow status values. UP long-press calls
    this function to update Load/Temp, MIDI/DAC/USB/Wi-Fi state, then redraw once.
    A short timed modal confirms the manual refresh using the existing popup style.
    """
    state.last_system_status_poll_time = time.time()
    state.cpu_load_text = get_cpu_load_text()
    state.cpu_temp_text = get_cpu_temp_text()
    periodic_device_poll(force=True)
    periodic_usb_poll(force=True)
    refresh_wifi_status(force=True)
    refresh_midi_display_text()
    mark_dirty(event)
    show_timed_modal_message(event, hold_sec=0.8, subtext=" ")


def force_volume_100() -> None:
    try:
        subprocess.run(["amixer", "sset", AMIXER_CONTROL, "100%"], stdout=subprocess.DEVNULL, stderr=subprocess.DEVNULL, check=False)
        state.volume_percent = 100
    except Exception:
        pass


def set_output_volume(percent: int, *, announce: bool = False) -> None:
    percent = max(0, min(100, int(percent)))
    try:
        subprocess.run(["amixer", "sset", AMIXER_CONTROL, f"{percent}%"], stdout=subprocess.DEVNULL, stderr=subprocess.DEVNULL, check=False)
        if percent != state.volume_percent:
            state.volume_percent = percent
        if announce:
            # Keep volume visible in the footer while the physical pot is being moved.
            state.last_volume_display_time = time.time()
            mark_dirty(f"Volume {percent}%")
    except Exception as exc:
        if announce:
            mark_dirty(f"Volume set failed: {exc}")


def save_volume_state(percent: int) -> None:
    try:
        Path(VOLUME_STATE_PATH).write_text(str(max(0, min(100, int(percent)))), encoding="utf-8")
    except Exception:
        pass


def load_saved_volume_state(default: int = 60) -> int:
    try:
        value = int(Path(VOLUME_STATE_PATH).read_text(encoding="utf-8").strip())
        return max(0, min(100, value))
    except Exception:
        return max(0, min(100, int(default)))


def enable_bluetooth_volume_override() -> None:
    """Use a fixed line level while Bluetooth source volume owns loudness."""
    if state.bluetooth_volume_override_active:
        return
    state.bluetooth_saved_volume_percent = int(state.volume_percent)
    state.bluetooth_volume_override_active = True
    set_output_volume(BLUETOOTH_OUTPUT_VOLUME_PERCENT, announce=False)


def restore_bluetooth_volume_override() -> None:
    """Restore the pre-Bluetooth system volume and POT ownership."""
    if not state.bluetooth_volume_override_active:
        return
    restore_percent = state.bluetooth_saved_volume_percent
    state.bluetooth_saved_volume_percent = None
    state.bluetooth_volume_override_active = False
    if restore_percent is not None:
        set_output_volume(restore_percent, announce=False)
    state.pot_volume_captured = False


def handle_pot_value(raw_value: str) -> None:
    if not POT_VOLUME_ENABLED or state.bluetooth_volume_override_active:
        return
    try:
        raw = int(raw_value)
    except ValueError:
        return
    raw = max(0, min(1023, raw))
    state.last_pot_raw = raw

    # Play with Drums can temporarily give the physical POT to CH10.  It uses
    # the same soft-takeover rule as master volume: the knob must first cross
    # the current drum level before it becomes active, preventing level jumps.
    if state.pot_mode == "DRUM" and state.ui_mode == "play_with_drums":
        percent = int(round(raw * 100 / 1023))
        if not state.adp_drum_volume_captured:
            if abs(percent - state.adp_drum_volume_percent) <= POT_VOLUME_PICKUP_THRESHOLD:
                state.adp_drum_volume_captured = True
                state.last_volume_display_time = time.time()
                mark_dirty(f"DRM {state.adp_drum_volume_percent}%")
            else:
                maybe_pulse_pot_led(percent)
                return
        if abs(percent - state.adp_drum_volume_percent) < POT_VOLUME_PERCENT_THRESHOLD:
            return
        set_adp_drum_volume(percent, announce=True)
        maybe_pulse_pot_led(percent)
        return

    # B: POT keeps volume as the default, but LEFT long can temporarily switch
    # it to PARAM mode. In PARAM mode, the full physical travel maps directly
    # to the currently highlighted Sound Edit CC value. No extra on-screen hint
    # is needed because the highlight already defines the target parameter.
    if state.pot_mode == "PARAM" and state.ui_mode == "sound_edit":
        value = clamp_cc_value(int(round(raw * SOUND_EDIT_MAX / 1023)))
        set_sound_edit_current_value_from_pot(value)
        maybe_pulse_pot_led(int(round(raw * 100 / 1023)))
        return

    percent = int(round(raw * 100 / 1023))

    # Startup volume policy 260627c:
    # Start from a fixed safe line-level value, then use soft takeover.
    # Do not let the first POT report jump the volume to an unrelated physical
    # knob position.  Volume resumes only after the pot enters the pickup range.
    if not state.initial_pot_volume_applied:
        state.initial_pot_volume_applied = True
        state.pot_startup_request_until = 0.0
        state.pot_volume_captured = False

    # Soft takeover for volume mode. If the pot has been used as a parameter
    # controller, its physical angle may no longer match the current volume.
    # When returning to VOL mode, wait until the pot is moved near the existing
    # logical volume before applying it again. This avoids sudden volume jumps.
    if not state.pot_volume_captured:
        if abs(percent - state.volume_percent) <= POT_VOLUME_PICKUP_THRESHOLD:
            state.pot_volume_captured = True
            show_timed_modal_message("Volume Active", hold_sec=0.8, subtext="Knob synchronized")
        else:
            maybe_pulse_pot_led(percent)
            return

    if abs(percent - state.volume_percent) < POT_VOLUME_PERCENT_THRESHOLD:
        return
    set_output_volume(percent, announce=True)
    save_volume_state(percent)
    maybe_pulse_pot_led(percent)

def normalize_path(path: str) -> str:
    return os.path.abspath(path)


def resolve_file_root() -> str:
    root = os.path.abspath(FILE_MEDIA_ROOT)
    os.makedirs(root, exist_ok=True)
    return root


def is_under_root(path: str, root: str) -> bool:
    try:
        return os.path.commonpath([os.path.abspath(path), os.path.abspath(root)]) == os.path.abspath(root)
    except Exception:
        return False


def find_file_root() -> str:
    for p in FILE_ROOT_CANDIDATES:
        if Path(p).exists():
            return p
    return "/home/pi"


def shorten_text(text: str, limit: int) -> str:
    text = (text or "").strip()
    if len(text) <= limit:
        return text
    if limit <= 3:
        return text[:limit]
    return text[:limit - 3] + "..."


def is_mountpoint_active(path: str) -> bool:
    return os.path.ismount(path)


def usb_status_text() -> str:
    return f"{USB_LABEL}:ON" if state.usb_mounted else f"{USB_LABEL}:---"


def get_file_source_entries() -> list[dict]:
    entries = [{"type": "source", "name": "local", "display": "Local files"}]
    if state.usb_mounted:
        entries.append({"type": "source", "name": "usb", "display": "USB drive"})
    entries.append({"type": "source", "name": "radio", "display": "Internet radio"})
    entries.append({"type": "source", "name": "bluetooth", "display": "Bluetooth audio"})
    return entries


def enter_file_source(default_usb: bool = False) -> None:
    entries = get_file_source_entries()
    state.ui_mode = "file_source"
    state.browser_index = 1 if (default_usb and len(entries) > 1) else 0
    invalidate_full_display()
    mark_dirty("File source")


def file_source_select() -> None:
    entries = get_file_source_entries()
    if not entries:
        mark_dirty("No source")
        return
    item = entries[clamp_index(state.browser_index, len(entries))]
    if item["name"] == "radio":
        enter_radio_browser()
        return
    if item["name"] == "bluetooth":
        start_bluetooth_audio_receiver()
        return
    state.browser_path = USB_MOUNT_POINT if item["name"] == "usb" else resolve_file_root()
    refresh_browser_entries()
    state.browser_index = 0
    state.ui_mode = "file_browser"
    invalidate_full_display()
    mark_dirty(item["display"])


def scan_adp_patterns() -> None:
    """Cache flat ADP files grouped by their three-letter filename prefix."""
    root = Path(ADP_PATTERN_DIR)
    grouped: dict[str, list[str]] = {}
    try:
        files = sorted(
            (p for p in root.iterdir() if p.is_file() and p.suffix.lower() == ".adp"),
            key=lambda p: p.name.lower(),
        )
    except Exception as exc:
        state.adp_error = str(exc)
        files = []

    for path in files:
        code = path.stem[:3].upper() or "DRM"
        grouped.setdefault(code, []).append(str(path))

    canonical = [code for code, _name in ADP_GENRES if code in grouped]
    unknown = sorted(code for code in grouped if code not in ADP_GENRE_NAME)
    state.adp_patterns_by_genre = grouped
    state.adp_genre_codes = canonical + unknown
    state.adp_genre_index = clamp_index(state.adp_genre_index, len(state.adp_genre_codes))
    state.adp_pattern_index = 0


def current_adp_genre_code() -> str:
    if not state.adp_genre_codes:
        return "DRM"
    return state.adp_genre_codes[clamp_index(state.adp_genre_index, len(state.adp_genre_codes))]


def current_adp_genre_name() -> str:
    code = current_adp_genre_code()
    return ADP_GENRE_NAME.get(code, code)


def current_adp_pattern_paths() -> list[str]:
    return state.adp_patterns_by_genre.get(current_adp_genre_code(), [])


def find_first_adp_file() -> Path | None:
    """Return the first cached ADP file in genre/pattern order."""
    paths = current_adp_pattern_paths()
    return Path(paths[0]) if paths else None

def crc16_ccitt(data: bytes) -> int:
    """CRC16-CCITT used by ADP v2.3 Final (poly 0x1021, init 0xFFFF)."""
    crc = 0xFFFF
    for byte in data:
        crc ^= int(byte) << 8
        for _ in range(8):
            if crc & 0x8000:
                crc = ((crc << 1) ^ 0x1021) & 0xFFFF
            else:
                crc = (crc << 1) & 0xFFFF
    return crc


def load_adp_slot_map(slot_map_id: int) -> list[int]:
    """Resolve one registered ADP slot map to representative GM MIDI notes."""
    if int(slot_map_id) == 255:
        raise ValueError("INLINE slot map is not supported by Fluid Ardule")
    try:
        maps = json.loads(Path(ADP_SLOT_MAP_PATH).read_text(encoding="utf-8"))
    except Exception as exc:
        raise ValueError(f"Cannot read slot map JSON: {exc}") from exc
    if not isinstance(maps, list):
        raise ValueError("Invalid slot map JSON: top level must be a list")
    selected = next((m for m in maps if int(m.get("slot_map_id", -1)) == int(slot_map_id)), None)
    if not isinstance(selected, dict):
        raise ValueError(f"Unknown SLOT_MAP_ID: {slot_map_id}")
    slots = selected.get("slots")
    if not isinstance(slots, list) or not slots:
        raise ValueError(f"SLOT_MAP_ID {slot_map_id} has no slots")
    ordered = sorted(slots, key=lambda item: int(item.get("slot", -1)))
    notes: list[int] = []
    for expected, item in enumerate(ordered):
        if int(item.get("slot", -1)) != expected:
            raise ValueError(f"SLOT_MAP_ID {slot_map_id} has non-contiguous slots")
        note = int(item.get("representative_midi", -1))
        if not 0 <= note <= 127:
            raise ValueError(f"SLOT_MAP_ID {slot_map_id} has invalid MIDI note")
        notes.append(note)
    if len(notes) > 16:
        raise ValueError("ADP slot map exceeds 16 slots")
    return notes


def load_adp_accent_velocities() -> list[int]:
    """Load ADP levels 0..5 from the 6-accent scheme in accent_levels.json."""
    try:
        data = json.loads(Path(ADP_ACCENT_LEVELS_PATH).read_text(encoding="utf-8"))
        levels = data["schemes"]["6-accent"]["levels"]
    except Exception as exc:
        raise ValueError(f"Cannot read 6-accent JSON: {exc}") from exc
    velocities = [None] * 6
    for item in levels:
        idx = int(item.get("index", -1))
        if 0 <= idx <= 5:
            velocity = int(item.get("representative_velocity", -1))
            if not 0 <= velocity <= 127:
                raise ValueError(f"Invalid representative velocity for accent {idx}")
            velocities[idx] = velocity
    if any(v is None for v in velocities):
        raise ValueError("6-accent JSON must define levels 0..5")
    return [int(v) for v in velocities]


def load_adp_pattern(path: str | Path) -> tuple[list[list[tuple[int, int]]], dict]:
    """Decode and validate one ADP v2.3 Final file."""
    p = Path(path)
    data = p.read_bytes()
    if len(data) < 12:
        raise ValueError("ADP header is truncated")
    if data[:4] != b"ADP3":
        raise ValueError("Unsupported ADP magic")
    version = data[4]
    if version != 23:
        raise ValueError(f"Unsupported ADP version: {version}")
    grid_code = data[5]
    if grid_code not in {0, 1, 2, 3}:
        raise ValueError(f"Unsupported ADP SUBDIV code: {grid_code}")
    step_count = data[6]
    if step_count == 0:
        raise ValueError("ADP LENGTH must not be zero")
    slot_map_id = data[7]
    payload_bytes = int.from_bytes(data[8:10], "little")
    expected_crc = int.from_bytes(data[10:12], "little")
    payload = data[12:]
    if payload_bytes != len(payload):
        raise ValueError("ADP payload length mismatch")
    actual_crc = crc16_ccitt(payload)
    if actual_crc != expected_crc:
        raise ValueError(f"ADP CRC mismatch: {actual_crc:04X}!={expected_crc:04X}")

    slot_notes = load_adp_slot_map(slot_map_id)
    accent_velocities = load_adp_accent_velocities()
    pos = 0
    steps: list[list[tuple[int, int]]] = []
    for _ in range(step_count):
        if pos >= len(payload):
            raise ValueError("ADP payload ended before all steps")
        hit_count = payload[pos]
        pos += 1
        hits: list[tuple[int, int]] = []
        seen_slots: set[int] = set()
        for _ in range(hit_count):
            if pos >= len(payload):
                raise ValueError("ADP hit data is truncated")
            packed = payload[pos]
            pos += 1
            if packed & 0x80:
                raise ValueError("ADP packed hit uses reserved bit 7")
            slot = packed >> 3
            accent = packed & 0x07
            if slot >= len(slot_notes):
                raise ValueError(f"ADP slot {slot} is outside SLOT_MAP_ID {slot_map_id}")
            if accent not in {1, 2, 3, 4, 5}:
                raise ValueError(f"Invalid ADP accent level: {accent}")
            if slot in seen_slots:
                raise ValueError(f"Duplicate ADP slot {slot} in one step")
            seen_slots.add(slot)
            hits.append((slot, accent))
        steps.append(hits)
    if pos != len(payload):
        raise ValueError("ADP payload has trailing bytes")
    return steps, {
        "grid_code": grid_code,
        "slot_map_id": slot_map_id,
        "slot_notes": slot_notes,
        "accent_velocities": accent_velocities,
        "step_count": step_count,
    }

def prepare_adp_pattern(path: str | Path) -> dict:
    steps, info = load_adp_pattern(path)
    p = Path(path)
    return {"path": str(p), "name": p.stem, "steps": steps, "info": info}


def apply_prepared_adp_pattern(prepared: dict, *, announce: bool = True) -> None:
    state.adp_path = str(prepared["path"])
    state.adp_name = str(prepared["name"])
    state.adp_steps = prepared["steps"]
    info = prepared["info"]
    state.adp_grid_code = int(info["grid_code"])
    state.adp_slot_map_id = int(info["slot_map_id"])
    state.adp_slot_notes = list(info["slot_notes"])
    state.adp_accent_velocities = list(info["accent_velocities"])
    # ADP v2.3 Final deliberately does not store tempo. Keep the user's current
    # Play with Drums tempo when browsing patterns; the page starts at 120 BPM.
    state.adp_pending_pattern = None
    if announce:
        mark_dirty(f"Pattern: {state.adp_name}")


def select_adp_pattern(path: str | Path) -> None:
    try:
        prepared = prepare_adp_pattern(path)
    except Exception as exc:
        state.adp_error = str(exc)
        mark_dirty("ADP load failed")
        return
    if state.adp_playing:
        state.adp_pending_pattern = prepared
        mark_dirty(f"Next bar: {prepared['name']}")
    else:
        apply_prepared_adp_pattern(prepared)


def move_adp_genre(delta: int) -> None:
    if not state.adp_genre_codes:
        mark_dirty("No ADP genres")
        return
    state.adp_genre_index = (state.adp_genre_index + int(delta)) % len(state.adp_genre_codes)
    state.adp_pattern_index = 0
    paths = current_adp_pattern_paths()
    if paths:
        select_adp_pattern(paths[0])


def move_adp_pattern(delta: int) -> None:
    paths = current_adp_pattern_paths()
    if not paths:
        mark_dirty("No patterns in genre")
        return
    state.adp_pattern_index = (state.adp_pattern_index + int(delta)) % len(paths)
    select_adp_pattern(paths[state.adp_pattern_index])


def cycle_adp_field() -> None:
    state.adp_selected_field = (state.adp_selected_field + 1) % len(ADP_FIELD_NAMES)
    mark_dirty(f"Select {ADP_FIELD_NAMES[state.adp_selected_field]}")


def move_adp_selected_value(delta: int) -> None:
    field_name = ADP_FIELD_NAMES[state.adp_selected_field]
    if field_name == "genre":
        move_adp_genre(delta)
    elif field_name == "pattern":
        move_adp_pattern(delta)
    else:
        move_adp_drum_kit(delta)


def adp_genre_position_label() -> str:
    total = len(state.adp_genre_codes)
    return f"[{clamp_index(state.adp_genre_index, total) + 1}/{total}]" if total else "[0/0]"


def adp_pattern_position_label() -> str:
    paths = current_adp_pattern_paths()
    total = len(paths)
    return f"[{clamp_index(state.adp_pattern_index, total) + 1}/{total}]" if total else "[0/0]"


def adp_kit_position_label(index: int | None = None) -> str:
    total = len(state.adp_drum_kits)
    if not total:
        return "[0/0]"
    idx = state.adp_drum_kit_index if index is None else int(index)
    return f"[{idx % total + 1}/{total}]"


def adp_step_interval_sec(grid_code: int, bpm: int) -> float:
    quarter = 60.0 / max(1, int(bpm))
    # ADP v2.3 Final: 16, 32, 8T, 16T = 4, 8, 3, 6 steps/quarter.
    divisor = {0: 4.0, 1: 8.0, 2: 3.0, 3: 6.0}.get(int(grid_code), 4.0)
    return quarter / divisor


def send_adp_note(slot: int, accent: int, on: bool) -> bool:
    if not (0 <= int(slot) < len(state.adp_slot_notes)):
        return False
    note = state.adp_slot_notes[int(slot)]
    if on:
        if not (1 <= int(accent) <= 5 and len(state.adp_accent_velocities) >= 6):
            return False
        velocity = state.adp_accent_velocities[int(accent)]
    else:
        velocity = 0
    command = f"noteon 9 {note} {velocity}" if on else f"noteoff 9 {note}"
    return send_fluidsynth_command(command)




def _play_adp_tap_hihat() -> None:
    """Play a short closed hi-hat without forwarding the tapped keyboard note."""
    send_fluidsynth_command(f"noteon 9 {ADP_TAP_HIHAT_NOTE} {ADP_TAP_HIHAT_VELOCITY}")

    def _off() -> None:
        time.sleep(ADP_TAP_HIHAT_LENGTH_SEC)
        send_fluidsynth_command(f"noteoff 9 {ADP_TAP_HIHAT_NOTE}")

    threading.Thread(target=_off, name="adp-tap-hihat", daemon=True).start()


def register_adp_tap(now: float | None = None) -> None:
    """Record one MIDI-key tap and update the candidate BPM."""
    if state.ui_mode != "adp_tap_tempo":
        return
    tap_time = time.monotonic() if now is None else float(now)
    if state.adp_tap_times and tap_time - state.adp_tap_times[-1] > 2.5:
        state.adp_tap_times.clear()
        state.adp_tap_measured_bpm = None
    state.adp_tap_times.append(tap_time)
    state.adp_tap_times = state.adp_tap_times[-ADP_TAP_HISTORY:]
    if len(state.adp_tap_times) >= 2:
        intervals = [b - a for a, b in zip(state.adp_tap_times, state.adp_tap_times[1:]) if b > a]
        if intervals:
            bpm = int(round(60.0 / (sum(intervals) / len(intervals))))
            state.adp_tap_measured_bpm = max(ADP_TAP_MIN_BPM, min(ADP_TAP_MAX_BPM, bpm))
    _play_adp_tap_hihat()
    mark_dirty("Tap")


def enter_adp_tap_tempo() -> None:
    """Enter Tap Tempo for ALSA Sequencer MIDI inputs only.

    USB Direct RAW is intentionally excluded.  FluidSynth owns the RAW device
    directly, and temporarily taking that device over through amidi adds enough
    process/IPC latency to make the audible tap feedback feel late.  ALSA SEQ
    inputs can be observed without restarting the engine, so their Note On
    events are used as the low-latency Tap Tempo source.
    """
    if state.midi_mode == "usb_direct_raw":
        show_timed_modal_message(
            "Tap Tempo unavailable",
            hold_sec=1.4,
            subtext="Select an ALSA MIDI mode",
        )
        return

    state.adp_tap_original_bpm = int(state.adp_bpm)
    state.adp_tap_resume_playback = bool(state.adp_playing)
    state.adp_tap_times.clear()
    state.adp_tap_measured_bpm = None
    if state.adp_playing:
        stop_adp_playback(announce=False)

    state.ui_mode = "adp_tap_tempo"
    state.adp_tap_route_disconnected = False
    if not state.combi_active:
        _disconnect_direct_midi_route()
        state.adp_tap_route_disconnected = True

    invalidate_full_display()
    mark_dirty("Tap Tempo")


def leave_adp_tap_tempo(*, apply: bool) -> None:
    """Apply/cancel the tempo, restore the ALSA MIDI route, and optionally resume."""
    if apply and state.adp_tap_measured_bpm is not None:
        state.adp_bpm = int(state.adp_tap_measured_bpm)
    else:
        state.adp_bpm = int(state.adp_tap_original_bpm)
    resume = bool(state.adp_tap_resume_playback)
    state.adp_tap_times.clear()
    state.adp_tap_measured_bpm = None
    state.adp_tap_resume_playback = False

    state.ui_mode = "play_with_drums"
    if state.adp_tap_route_disconnected:
        reconnect_midi_to_fluidsynth(force_draw=False)

    state.adp_tap_route_disconnected = False
    invalidate_full_display()
    mark_dirty("Tempo applied" if apply else "Tap canceled")
    if resume:
        start_adp_playback()

def supported_adp_soundfont() -> bool:
    """Return True for the three GM SoundFonts supported by Play with Drums."""
    try:
        base = Path(SOUNDFONTS[state.sf_index][0]).name.lower()
    except Exception:
        return False
    return base in {"fluidr3_gm.sf2", "generaluser_gs.sf2", "arachno_gm.sf2"}


def set_adp_drum_volume(percent: int, *, announce: bool = False) -> bool:
    """Set CH10 drum level with MIDI CC7 while leaving other channels unchanged."""
    percent = max(0, min(100, int(percent)))
    value = int(round(percent * 127 / 100))
    ok = send_fluidsynth_command(f"cc 9 7 {value}")
    if ok:
        state.adp_drum_volume_percent = percent
        if announce:
            # Use the common volume footer so the active POT target is obvious:
            # VOL xx% for master, DRM xx% for CH10 drum level.
            state.last_volume_display_time = time.time()
            mark_dirty(f"DRM {percent}%")
    elif announce:
        show_footer_message("Drum Volume send failed", 1.2)
    return ok


def toggle_adp_drum_pot_mode() -> None:
    """Toggle POT between master volume and CH10 drum volume with pickup."""
    if state.pot_mode == "DRUM":
        state.pot_mode = "VOL"
        state.pot_volume_captured = False
        show_footer_message(f"POT: VOL {state.volume_percent}%", POT_MODE_FOOTER_HOLD_SEC)
    else:
        state.pot_mode = "DRUM"
        state.adp_drum_volume_captured = False
        state.pot_volume_captured = False
        show_footer_message(f"POT: DRUM {state.adp_drum_volume_percent}%", POT_MODE_FOOTER_HOLD_SEC)


def load_adp_drum_kits() -> None:
    """Build the CH10 drum-kit list from the active SoundFont preset JSON."""
    kits = [p for p in load_presets_for_sf2(state.sf_index)
            if int(p.get("bank", 0)) == 128 or bool(p.get("is_drum"))]
    if not kits:
        kits = [{"name": "GM Standard", "bank": 128, "program": 0, "engine": "fluidsynth", "is_drum": True}]
    state.adp_drum_kits = kits
    state.adp_drum_kit_index = 0
    state.adp_pending_drum_kit_index = None


def adp_drum_kit_name(index: int | None = None) -> str:
    kits = state.adp_drum_kits
    if not kits:
        return "GM Standard"
    idx = state.adp_drum_kit_index if index is None else int(index)
    idx %= len(kits)
    return str(kits[idx].get("name", "Drum Kit"))


def apply_adp_drum_kit(index: int, *, announce: bool = True) -> bool:
    """Apply one SoundFont drum preset to FluidSynth CH10 only."""
    if not state.adp_drum_kits:
        return False
    idx = int(index) % len(state.adp_drum_kits)
    kit = state.adp_drum_kits[idx]
    bank = int(kit.get("bank", 128))
    program = int(kit.get("program", 0))
    ok = False
    ok = send_fluidsynth_command("drums 9 on") or ok
    ok = send_fluidsynth_command(f"bank 9 {bank}") or ok
    ok = send_fluidsynth_command(f"prog 9 {program}") or ok
    ok = send_fluidsynth_command(f"select 9 {RESIDENT_GM_SFID} {bank} {program}") or ok
    # Program/bank changes may reset channel controllers in some SoundFonts;
    # keep the user's Play with Drums balance stable across kit changes.
    set_adp_drum_volume(state.adp_drum_volume_percent, announce=False)
    state.adp_drum_kit_index = idx
    state.adp_pending_drum_kit_index = None
    if announce:
        mark_dirty(f"Drum Kit: {adp_drum_kit_name(idx)}")
    return ok


def move_adp_drum_kit(delta: int) -> None:
    """Select a drum kit; while playing, queue it for the next bar boundary."""
    if not state.adp_drum_kits:
        mark_dirty("No drum kits")
        return
    base = state.adp_pending_drum_kit_index
    if base is None:
        base = state.adp_drum_kit_index
    target = (int(base) + int(delta)) % len(state.adp_drum_kits)
    if state.adp_playing:
        state.adp_pending_drum_kit_index = target
        mark_dirty(f"Next bar: {adp_drum_kit_name(target)}")
    else:
        apply_adp_drum_kit(target)

def _adp_playback_worker() -> None:
    try:
        interval = adp_step_interval_sec(state.adp_grid_code, state.adp_bpm)
        deadline = time.monotonic()
        step_index = 0
        while not adp_stop_event.is_set() and state.adp_steps:
            # ADP has no time-signature field. For the existing 4/4 Play with
            # Drums workflow, v2.3 Final uses 16/32/8T/16T = 16/32/12/24 steps/bar.
            steps_per_bar = {0: 16, 1: 32, 2: 12, 3: 24}.get(int(state.adp_grid_code), 16)
            if step_index % steps_per_bar == 0:
                if state.adp_pending_pattern is not None:
                    apply_prepared_adp_pattern(state.adp_pending_pattern, announce=False)
                    step_index = 0
                    steps_per_bar = {0: 16, 1: 32, 2: 12, 3: 24}.get(int(state.adp_grid_code), 16)
                    mark_dirty(f"Pattern: {state.adp_name}")
                if state.adp_pending_drum_kit_index is not None:
                    apply_adp_drum_kit(state.adp_pending_drum_kit_index, announce=False)
                    mark_dirty(f"Drum Kit: {adp_drum_kit_name()}")
            interval = adp_step_interval_sec(state.adp_grid_code, state.adp_bpm)
            hits = state.adp_steps[step_index]
            active_slots = []
            for slot, accent in hits:
                if send_adp_note(slot, accent, True):
                    active_slots.append(slot)

            note_deadline = min(deadline + ADP_NOTE_LENGTH_SEC, deadline + interval)
            wait_time = note_deadline - time.monotonic()
            if wait_time > 0 and adp_stop_event.wait(wait_time):
                break
            for slot in active_slots:
                send_adp_note(slot, 0, False)

            step_index = (step_index + 1) % len(state.adp_steps)
            deadline += interval
            wait_time = deadline - time.monotonic()
            if wait_time > 0:
                if adp_stop_event.wait(wait_time):
                    break
            elif wait_time < -interval:
                # If the Pi was briefly delayed, resynchronize without adding a
                # pause at the loop boundary or rapidly replaying missed steps.
                deadline = time.monotonic()
    except Exception as exc:
        state.adp_error = str(exc)
        log(f"ADP playback failed: {exc}")
    finally:
        send_fluidsynth_command("cc 9 123 0")
        send_fluidsynth_command("cc 9 120 0")
        state.adp_playing = False
        mark_dirty("Drums stopped")


def start_adp_playback() -> None:
    global adp_play_thread
    if state.current_engine != "fluidsynth":
        show_timed_modal_message("FluidSynth required", hold_sec=1.2, subtext="ADP uses the loaded SoundFont")
        return
    if not state.adp_steps:
        show_timed_modal_message("No ADP pattern", hold_sec=1.2, subtext=state.adp_error or ADP_PATTERN_DIR)
        return
    stop_adp_playback(announce=False)
    adp_stop_event.clear()
    state.adp_playing = True
    adp_play_thread = threading.Thread(target=_adp_playback_worker, name="adp-playback", daemon=True)
    adp_play_thread.start()
    set_play_led("ON")
    mark_dirty("Drums playing")


def stop_adp_playback(*, announce: bool = True) -> None:
    global adp_play_thread
    adp_stop_event.set()
    thread = adp_play_thread
    if thread and thread.is_alive() and thread is not threading.current_thread():
        thread.join(timeout=0.5)
    adp_play_thread = None
    state.adp_playing = False
    send_fluidsynth_command("cc 9 123 0")
    send_fluidsynth_command("cc 9 120 0")
    set_play_led("OFF")
    if announce:
        mark_dirty("Drums stopped")


def enter_play_with_drums() -> None:
    stop_adp_playback(announce=False)
    state.adp_error = ""

    # Preserve an already loaded Combi.  Its CH1 keyboard routing remains
    # active while this page adds ADP drums on CH10.  Outside Combi mode,
    # automatically load GeneralUser GS when the current source is not one of
    # the supported GM SoundFonts.
    if not state.combi_active and not supported_adp_soundfont():
        apply_soundfont_with_default_preset(generaluser_soundfont_index())

    state.adp_source_sf_name = state.sf_name or "SoundFont"
    state.adp_source_preset_name = state.current_combi_name if state.combi_active else state.current_preset_name
    state.adp_selected_field = 0
    state.adp_pending_pattern = None
    state.adp_bpm = ADP_DEFAULT_BPM
    # Enter in normal master-volume mode. Drum balance is retained in runtime
    # and can be picked up explicitly with LEFT long.
    state.pot_mode = "VOL"
    state.pot_volume_captured = False
    state.adp_drum_volume_captured = False
    load_adp_drum_kits()
    apply_adp_drum_kit(0, announce=False)
    set_adp_drum_volume(state.adp_drum_volume_percent, announce=False)
    scan_adp_patterns()
    path = find_first_adp_file()
    if path is None:
        state.adp_path = None
        state.adp_name = "No ADP pattern"
        state.adp_steps = []
    else:
        try:
            apply_prepared_adp_pattern(prepare_adp_pattern(path), announce=False)
        except Exception as exc:
            state.adp_path = str(path)
            state.adp_name = path.stem
            state.adp_steps = []
            state.adp_error = str(exc)
    state.ui_mode = "play_with_drums"
    invalidate_full_display()
    mark_dirty("Play with Drums")


def leave_play_with_drums() -> None:
    stop_adp_playback(announce=False)
    if state.pot_mode == "DRUM":
        state.pot_mode = "VOL"
        state.pot_volume_captured = False
        state.adp_drum_volume_captured = False
    restore_quick_snapshot()


def toggle_adp_playback() -> None:
    if state.adp_playing:
        stop_adp_playback()
    else:
        start_adp_playback()


def ensure_radio_files_on_demand() -> None:
    """Create radio JSON files only when the Radio screen is used.

    This keeps startup/main-loop/UNO timing identical to the stable script.
    """
    sf2_dir = Path("/home/pi/sf2")
    sf2_dir.mkdir(parents=True, exist_ok=True)
    stations_path = Path(RADIO_STATIONS_PATH)
    favorites_path = Path(RADIO_FAVORITES_PATH)
    if not stations_path.exists():
        stations_path.write_text(json.dumps(DEFAULT_RADIO_STATIONS, indent=2, ensure_ascii=False) + "\n", encoding="utf-8")
    if not favorites_path.exists():
        favorites_path.write_text("[]\n", encoding="utf-8")


def load_radio_stations() -> list[dict]:
    ensure_radio_files_on_demand()
    try:
        data = json.loads(Path(RADIO_STATIONS_PATH).read_text(encoding="utf-8"))
        if not isinstance(data, list):
            data = []
    except Exception as exc:
        log(f"radio_stations.json load failed: {exc}")
        data = []

    by_id: dict[str, dict] = {}
    for item in data + DEFAULT_RADIO_STATIONS:
        if not isinstance(item, dict):
            continue
        sid = str(item.get("id") or item.get("name") or "").strip()
        name = str(item.get("name") or sid).strip()
        url = str(item.get("url") or "").strip()
        if not sid or not name or not url:
            continue
        if sid not in by_id:
            by_id[sid] = {"id": sid, "name": name, "url": url}
    return list(by_id.values())


def load_radio_favorites() -> set[str]:
    ensure_radio_files_on_demand()
    try:
        data = json.loads(Path(RADIO_FAVORITES_PATH).read_text(encoding="utf-8"))
        if isinstance(data, list):
            return {str(x).strip() for x in data if str(x).strip()}
    except Exception as exc:
        log(f"radio_favorites.json load failed: {exc}")
    return set()


def save_radio_favorites(favorites: set[str]) -> None:
    ensure_radio_files_on_demand()
    Path(RADIO_FAVORITES_PATH).write_text(json.dumps(sorted(favorites), indent=2, ensure_ascii=False) + "\n", encoding="utf-8")


def load_radio_entries_for_view(view_mode: str) -> list[dict]:
    stations = load_radio_stations()
    if view_mode == "favorites":
        favorites = load_radio_favorites()
        return [s for s in stations if str(s.get("id", "")).strip() in favorites]
    return stations


def enter_radio_browser(view_mode: str = "all", *, keep_index: bool = False) -> None:
    if view_mode not in {"all", "favorites"}:
        view_mode = "all"
    old_index = state.radio_index
    state.radio_view_mode = view_mode
    state.radio_entries = load_radio_entries_for_view(view_mode)
    state.radio_index = clamp_index(old_index if keep_index else 0, len(state.radio_entries))
    state.ui_mode = "radio_browser"
    invalidate_full_display()
    if view_mode == "favorites":
        mark_dirty(f"Radio favorites: {len(state.radio_entries)}")
    else:
        mark_dirty(f"Radio: {len(state.radio_entries)} stations")


def current_radio_station() -> dict | None:
    if radio_index_is_favorites_entry():
        return None
    if not state.radio_entries:
        return None
    return state.radio_entries[clamp_index(radio_station_index(), len(state.radio_entries))]


def radio_display_labels() -> list[str]:
    favorites = load_radio_favorites()
    labels = []
    if state.radio_view_mode == "all":
        labels.append("★ Favorites")
    for station in state.radio_entries:
        star = "★ " if str(station.get("id", "")) in favorites else "  "
        labels.append(star + str(station.get("name", "Radio")))
    return labels


def radio_index_is_favorites_entry() -> bool:
    return state.radio_view_mode == "all" and state.radio_index == 0


def radio_station_index() -> int:
    return state.radio_index - 1 if state.radio_view_mode == "all" else state.radio_index


def find_radio_station_by_id(station_id: str | None) -> dict | None:
    sid = str(station_id or "").strip()
    if not sid:
        return None
    for station in load_radio_stations():
        if str(station.get("id", "")).strip() == sid:
            return station
    return None


def toggle_current_radio_favorite() -> None:
    station = current_radio_station()
    if not station:
        mark_dirty("No station")
        return
    sid = str(station.get("id", "")).strip()
    if not sid:
        mark_dirty("No station id")
        return
    favorites = load_radio_favorites()
    if sid in favorites:
        favorites.remove(sid)
        msg = "Favorite removed"
    else:
        favorites.add(sid)
        msg = "Favorite added"
    save_radio_favorites(favorites)
    if state.radio_view_mode == "favorites":
        old_index = state.radio_index
        state.radio_entries = load_radio_entries_for_view("favorites")
        state.radio_index = clamp_index(old_index, len(state.radio_entries))
    invalidate_full_display()
    mark_dirty(msg)

def toggle_radio_favorite_by_id(station_id: str | None, station_name: str | None = None) -> None:
    """Toggle favorite for the currently playing radio station.

    Player mode does not necessarily have a valid radio_browser selection, so
    do not rely on current_radio_station() here.
    This is used by the RIGHT/Favorite button while Internet radio is playing.
    """
    sid = str(station_id or "").strip()
    if not sid:
        mark_dirty("No station id")
        return

    # Resolve a human-readable name only for status text.  Do not require the
    # station list to be available; the station id is the authoritative key.
    name = str(station_name or "").strip()
    if not name:
        station = find_radio_station_by_id(sid)
        if station:
            name = str(station.get("name", "")).strip()

    favorites = load_radio_favorites()
    if sid in favorites:
        favorites.remove(sid)
        msg = "Favorite removed"
    else:
        favorites.add(sid)
        msg = "Favorite added"
    save_radio_favorites(favorites)

    # Keep the favorites view coherent if the user returns there immediately.
    if state.radio_view_mode == "favorites":
        old_index = state.radio_index
        state.radio_entries = load_radio_entries_for_view("favorites")
        state.radio_index = clamp_index(old_index, len(state.radio_entries))

    invalidate_full_display()
    if name:
        mark_dirty(f"{msg}: {shorten_text(name, 18)}")
    else:
        mark_dirty(msg)



def play_adjacent_radio_station(delta: int) -> None:
    """Move to the previous/next station while Internet radio is playing.

    This mirrors file playback's adjacent-item behavior, but uses the active
    radio view (all/favorites) and does not wrap at either end.
    """
    if state.player_proc_kind != "radio" and state.player_return_mode != "radio_browser":
        mark_dirty("Radio not active")
        return

    if not state.radio_entries:
        state.radio_entries = load_radio_entries_for_view(state.radio_view_mode)
    if not state.radio_entries:
        show_player_notice("No stations")
        return

    current_id = str(state.player_radio_station_id or "").strip()
    current_pos = None
    if current_id:
        for i, station in enumerate(state.radio_entries):
            if str(station.get("id", "")).strip() == current_id:
                current_pos = i
                break

    if current_pos is None:
        # Fall back to the browser selection.  In the all-stations view the
        # first display row is "Favorites", so convert the display index back
        # to a station index.
        current_pos = radio_station_index() if state.radio_view_mode == "all" else state.radio_index
        current_pos = clamp_index(current_pos, len(state.radio_entries))

    next_pos = current_pos + int(delta)
    if next_pos < 0:
        show_player_notice("First station")
        return
    if next_pos >= len(state.radio_entries):
        show_player_notice("Last station")
        return

    state.radio_index = next_pos + (1 if state.radio_view_mode == "all" else 0)
    station = state.radio_entries[next_pos]
    log(f"RADIO adjacent delta={delta} next={station.get('name','Radio')}")
    start_radio_station(station)

def start_radio_station(station: dict) -> None:
    url = str(station.get("url", "")).strip()
    name = str(station.get("name", "Radio")).strip() or "Radio"
    if not url:
        mark_dirty("No radio URL")
        return

    send_ui_status("BUSY", force=True)
    global player_proc
    stop_player_only()
    stop_fluidsynth()

    audio = state.audio_device
    mpv_audio = "alsa/default" if audio == "default" else f"alsa/{audio}"
    cmd = [
        "mpv",
        "--no-video",
        "--really-quiet",
        "--no-terminal",
        "--idle=no",
        f"--audio-device={mpv_audio}",
        url,
    ]

    show_modal_message("Connecting radio...", shorten_text(name, 24))
    log(f"RADIO cmd={' '.join(cmd)}")
    log_handle = open_player_log()
    try:
        player_proc = subprocess.Popen(cmd, stdout=log_handle, stderr=log_handle, preexec_fn=os.setsid, text=True)
    except FileNotFoundError:
        restart_engine(state.sf_index, state.dac_index, manage_modal=False)
        clear_modal_message()
        mark_dirty("mpv missing")
        send_ui_status("READY", force=True)
        return
    except Exception as exc:
        restart_engine(state.sf_index, state.dac_index)
        clear_modal_message()
        mark_dirty(f"Radio failed: {exc}")
        send_ui_status("READY", force=True)
        return

    state.player_path = name
    state.player_proc_kind = "radio"
    state.player_paused = False
    state.player_status = "Playing"
    state.player_stop_requested = False
    state.player_origin_dir = None
    state.player_return_mode = "radio_browser"
    state.player_radio_station_id = str(station.get("id", "")).strip() or None
    state.ui_mode = "player"
    invalidate_full_display()
    set_play_led("ON")
    clear_modal_message()
    mark_dirty(f"Radio: {name}")
    send_ui_status("READY", force=True)



def _bluetoothctl_lines(*commands: str) -> tuple[int, str]:
    """Run a short bluetoothctl command sequence non-interactively."""
    if not commands:
        return 1, ""
    payload = "\n".join(str(cmd).strip() for cmd in commands if str(cmd).strip()) + "\n"
    try:
        proc = subprocess.run(
            ["bluetoothctl", "--timeout", "3"],
            input=payload,
            text=True,
            stdout=subprocess.PIPE,
            stderr=subprocess.STDOUT,
            check=False,
            timeout=5.0,
        )
        return proc.returncode, proc.stdout.strip()
    except Exception as exc:
        return 1, str(exc)


def bluetooth_connected_device() -> tuple[str | None, str | None]:
    """Return (MAC, display name) for the currently connected device only.

    Trusted devices that are not connected are intentionally ignored. Bluetooth
    pairing/trust remains a Console/SSH concern; the player screen reports only
    the device that is actually connected now.
    """
    code, out = run_cmd(["bluetoothctl", "--timeout", "3", "devices", "Connected"])
    if code != 0 or not out:
        return None, None
    for line in out.splitlines():
        match = re.match(r"^Device\s+([0-9A-Fa-f:]{17})\s+(.+)$", line.strip())
        if not match:
            continue
        mac = match.group(1)
        fallback_name = match.group(2).strip()
        info_code, info_out = run_cmd(["bluetoothctl", "--timeout", "3", "info", mac])
        if info_code == 0 and info_out:
            alias = re.search(r"^\s*Alias:\s*(.+)$", info_out, flags=re.M)
            name = re.search(r"^\s*Name:\s*(.+)$", info_out, flags=re.M)
            if alias and alias.group(1).strip():
                return mac, alias.group(1).strip()
            if name and name.group(1).strip():
                return mac, name.group(1).strip()
        return mac, fallback_name or "Bluetooth device"
    return None, None


def bluetooth_streaming_active(mac: str | None) -> bool:
    """Best-effort BlueALSA streaming-state check.

    BlueALSA versions differ in CLI detail output. When an explicit running or
    active flag is unavailable, the UI safely remains at Connected.
    """
    if not mac:
        return False
    code, out = run_cmd(["bluealsa-cli", "list-pcms"])
    if code != 0 or not out:
        return False
    mac_compact = mac.replace(":", "_").lower()
    candidates = [line.strip() for line in out.splitlines() if mac.lower() in line.lower() or mac_compact in line.lower()]
    for pcm in candidates:
        info_code, info_out = run_cmd(["bluealsa-cli", "info", pcm])
        if info_code == 0 and re.search(r"^\s*(?:Running|Active):\s*(?:true|yes|1)\s*$", info_out, flags=re.I | re.M):
            return True
    return False


def periodic_bluetooth_status_poll() -> None:
    """Refresh the Bluetooth Audio screen only while receiver mode is active."""
    if state.player_proc_kind != "bluetooth" or state.ui_mode != "player":
        return
    now = time.time()
    if now - state.last_bluetooth_status_poll_time < BLUETOOTH_STATUS_POLL_INTERVAL_SEC:
        return
    state.last_bluetooth_status_poll_time = now

    mac, name = bluetooth_connected_device()
    new_path = name or "Waiting for device..."
    if mac:
        new_status = "Streaming" if bluetooth_streaming_active(mac) else "Connected"
    else:
        new_status = "Waiting"

    if new_path != state.player_path or new_status != state.player_status:
        state.player_path = new_path
        state.player_status = new_status
        mark_dirty("Bluetooth status")


def start_bluetooth_audio_receiver() -> None:
    """Enter exclusive Bluetooth A2DP receiver mode using BlueALSA.

    Pairing and trust management remain manual Console/SSH operations.
    This mode intentionally stops the internal synth engine and does not mix
    Bluetooth audio with live keyboard sound.
    """
    global player_proc
    send_ui_status("BUSY", force=True)
    show_modal_message("Starting Bluetooth...", "Waiting for paired device")

    stop_player_only()
    stop_fluidsynth()
    enable_bluetooth_volume_override()

    cmd = [BLUETOOTH_APLAY_EXECUTABLE, "-D", state.audio_device]
    log(f"BLUETOOTH cmd={' '.join(cmd)}")
    log_handle = open_player_log()
    try:
        player_proc = subprocess.Popen(
            cmd,
            stdout=log_handle,
            stderr=log_handle,
            preexec_fn=os.setsid,
            text=True,
        )
        time.sleep(0.2)
        if player_proc.poll() is not None:
            raise RuntimeError("bluealsa-aplay exited immediately")
    except FileNotFoundError:
        player_proc = None
        restore_bluetooth_volume_override()
        restart_engine(state.sf_index, state.dac_index, manage_modal=False)
        restore_current_preset_after_engine_restart()
        clear_modal_message()
        mark_dirty("bluealsa-aplay missing")
        send_ui_status("READY", force=True)
        return
    except Exception as exc:
        player_proc = None
        restore_bluetooth_volume_override()
        restart_engine(state.sf_index, state.dac_index, manage_modal=False)
        restore_current_preset_after_engine_restart()
        clear_modal_message()
        mark_dirty(f"Bluetooth failed: {exc}")
        send_ui_status("READY", force=True)
        return

    state.player_path = "Waiting for device..."
    state.player_proc_kind = "bluetooth"
    state.player_paused = False
    state.player_status = "Waiting"
    state.player_stop_requested = False
    state.player_origin_dir = None
    state.player_return_mode = "file_source"
    state.player_radio_station_id = None
    state.ui_mode = "player"
    invalidate_full_display()
    set_play_led("ON")
    clear_modal_message()
    mark_dirty("Bluetooth receiver active")
    send_ui_status("READY", force=True)


# =========================================================
# Wi-Fi helpers
# =========================================================

def wifi_conf_paths() -> list[str]:
    """Return existing wpa_supplicant config paths, wlan0-specific first.

    Raspberry Pi OS may run wpa_supplicant@wlan0 with
    /etc/wpa_supplicant/wpa_supplicant-wlan0.conf, while older setups use
    /etc/wpa_supplicant/wpa_supplicant.conf.  Keep both in sync when both
    exist, but prefer the wlan0-specific file for reading.
    """
    paths: list[str] = []
    for p in (WPA_SUPPLICANT_CONF, WPA_SUPPLICANT_CONF_FALLBACK):
        if p and p not in paths and Path(p).exists():
            paths.append(p)
    if not paths:
        paths.append(WPA_SUPPLICANT_CONF)
    return paths


def read_wifi_conf_text(path: str) -> str:
    """Read a root-protected wpa_supplicant config safely.

    The config is normally 600 root:root. Fluid Ardule usually runs as the
    pi user, so direct open() may fail even though systemd can use the file.
    Try normal read first, then fall back to sudo cat with non-interactive
    sudo. This keeps the main Python process non-root.
    """
    try:
        return Path(path).read_text(encoding="utf-8", errors="ignore")
    except PermissionError:
        code, out = run_cmd(["sudo", "-n", "cat", path])
        if code == 0:
            return out
        log(f"Wi-Fi config sudo read failed ({path}): {out}")
        return ""
    except Exception as exc:
        log(f"Wi-Fi config read failed ({path}): {exc}")
        return ""


def _decode_wpa_quoted_ssid(value: str) -> str:
    """Decode only wpa_supplicant backslash escapes without corrupting UTF-8 SSIDs."""
    value = str(value or "")
    value = value.replace(r"\\", "\0")
    value = value.replace(r'\"', '"')
    value = value.replace(r"\n", "\n").replace(r"\r", "\r").replace(r"\t", "\t")
    return value.replace("\0", "\\")


def parse_wpa_supplicant_networks(conf_path: str | None = None, *, force: bool = False) -> list[str]:
    """Return the union of configured SSIDs from the available wpa_supplicant files."""
    global _wifi_known_ssids_cache_until, _wifi_known_ssids_cache
    now = time.time()
    if conf_path is None and not force and now < _wifi_known_ssids_cache_until:
        return list(_wifi_known_ssids_cache)

    paths = [conf_path] if conf_path else wifi_conf_paths()
    ssids: list[str] = []

    for path in paths:
        text = read_wifi_conf_text(path)
        if not text:
            continue
        for block in re.findall(r'network\s*=\s*\{(.*?)\}', text, flags=re.S):
            m = re.search(r'^\s*ssid\s*=\s*"((?:\\.|[^"\\])*)"', block, flags=re.M)
            if not m:
                continue
            ssid = _decode_wpa_quoted_ssid(m.group(1))
            if ssid and ssid not in ssids:
                ssids.append(ssid)

    if conf_path is None:
        _wifi_known_ssids_cache = list(ssids)
        _wifi_known_ssids_cache_until = now + WIFI_KNOWN_SSIDS_CACHE_SEC
    return ssids


def wifi_is_enabled() -> bool:
    code, out = run_cmd(["rfkill", "list", "wifi"])
    if code == 0 and out:
        return "Soft blocked: yes" not in out
    return Path(f"/sys/class/net/{WIFI_INTERFACE}").exists()


def wifi_current_ssid() -> str:
    code, out = run_cmd(["iwgetid", WIFI_INTERFACE, "-r"])
    if code == 0 and out.strip():
        return out.strip()

    # Robust fallback when wireless-tools reports nothing although iw sees a link.
    code, out = run_cmd(["iw", "dev", WIFI_INTERFACE, "link"])
    if code == 0 and out:
        m = re.search(r"^\s*SSID:\s*(.+?)\s*$", out, flags=re.M)
        if m:
            return m.group(1).strip()
    return ""


def wifi_ipv4_address() -> str:
    """Return the DHCP-assigned IPv4 address of the Wi-Fi interface."""
    code, out = run_cmd(["ip", "-4", "-o", "addr", "show", "dev", WIFI_INTERFACE, "scope", "global"])
    if code != 0 or not out:
        return ""
    match = re.search(r"\binet\s+(\d+(?:\.\d+){3})/\d+", out)
    return match.group(1) if match else ""


def refresh_wifi_status(*, force: bool = False) -> None:
    """Refresh Wi-Fi status with a short cache for UI redraw safety."""
    global _wifi_status_cache_until
    now = time.time()
    if not force and now < _wifi_status_cache_until:
        return
    state.wifi_enabled = wifi_is_enabled()
    state.wifi_current_ssid = wifi_current_ssid() if state.wifi_enabled else ""
    state.wifi_ipv4_address = wifi_ipv4_address() if state.wifi_current_ssid else ""
    state.wifi_known_ssids = parse_wpa_supplicant_networks(force=force)
    _wifi_status_cache_until = now + WIFI_STATUS_CACHE_SEC


def wifi_status_label(*, short: bool = False) -> str:
    refresh_wifi_status()
    if not state.wifi_enabled:
        return "Off"
    if state.wifi_current_ssid:
        if state.wifi_ipv4_address:
            return (
                f"{state.wifi_current_ssid}: {state.wifi_ipv4_address}"
                if short
                else f"Connected: {state.wifi_current_ssid} / {state.wifi_ipv4_address}"
            )
        return state.wifi_current_ssid if short else f"Connected: {state.wifi_current_ssid}"
    return "On" if short else "On / not connected"


def restart_wifi_services() -> bool:
    """Restart OS-managed Wi-Fi services and let priority choose the AP."""
    ok = True
    commands = [
        ["sudo", "-n", "systemctl", "restart", f"wpa_supplicant@{WIFI_INTERFACE}"],
        ["sudo", "-n", "systemctl", "restart", "dhcpcd"],
    ]
    for cmd in commands:
        code, out = run_cmd(cmd)
        if code != 0:
            ok = False
            log(f"Wi-Fi service command failed: {' '.join(cmd)} :: {out}")
    return ok


def set_wifi_enabled(enabled: bool) -> bool:
    if enabled:
        run_cmd(["sudo", "-n", "rfkill", "unblock", "wifi"])
        run_cmd(["sudo", "-n", "ip", "link", "set", WIFI_INTERFACE, "up"])
        restart_wifi_services()
    else:
        run_cmd(["sudo", "-n", "rfkill", "block", "wifi"])
    refresh_wifi_status(force=True)
    return state.wifi_enabled == enabled


def _collect_ssids_from_scan_output(out: str, detected: set[str]) -> None:
    """Accept output from iw, iwlist, or wpa_cli scan_results."""
    if not out:
        return
    for line in out.splitlines():
        stripped = line.strip()
        if stripped.startswith("SSID: "):
            ssid = stripped.split("SSID: ", 1)[1].strip()
            if ssid:
                detected.add(ssid)
    for ssid in re.findall(r'ESSID:"(.*?)"', out):
        if ssid:
            detected.add(ssid)
    # wpa_cli scan_results: bssid / frequency / signal / flags / ssid
    for line in out.splitlines():
        if "\t" not in line or line.lower().startswith("bssid"):
            continue
        parts = line.split("\t", 4)
        if len(parts) == 5 and parts[4].strip():
            detected.add(parts[4].strip())


def scan_wifi_ssids() -> list[str]:
    """Return configured SSIDs that are currently visible.

    Try multiple scan paths because an associated wlan0 may reject one scanner
    while another still has useful results. The current SSID is always retained.
    """
    known = parse_wpa_supplicant_networks(force=True)
    state.wifi_known_ssids = known
    if not wifi_is_enabled():
        state.wifi_scan_results = []
        refresh_wifi_status(force=True)
        return []

    detected: set[str] = set()
    current = wifi_current_ssid()
    if current:
        detected.add(current)

    scan_commands = [
        ["sudo", "-n", "iw", "dev", WIFI_INTERFACE, "scan"],
        ["sudo", "-n", "iwlist", WIFI_INTERFACE, "scan"],
        ["sudo", "-n", "wpa_cli", "-i", WIFI_INTERFACE, "scan_results"],
    ]
    for cmd in scan_commands:
        try:
            p = subprocess.run(
                cmd,
                text=True,
                stdout=subprocess.PIPE,
                stderr=subprocess.STDOUT,
                check=False,
                timeout=WIFI_SCAN_TIMEOUT_SEC,
            )
            if p.returncode == 0:
                _collect_ssids_from_scan_output(p.stdout or "", detected)
        except (subprocess.TimeoutExpired, FileNotFoundError):
            continue
        except Exception as exc:
            log(f"Wi-Fi scan failed ({' '.join(cmd)}): {exc}")

    visible_known = [ssid for ssid in known if ssid in detected]
    # Never hide the active configured network just because an active scan failed.
    if current in known and current not in visible_known:
        visible_known.insert(0, current)

    state.wifi_scan_results = visible_known
    refresh_wifi_status(force=True)
    return visible_known


def update_priorities_in_wpa_text(text: str, selected_ssid: str) -> tuple[str, bool]:
    """Return config text with selected_ssid priority raised."""
    changed = False

    def repl(match: re.Match) -> str:
        nonlocal changed
        block = match.group(0)
        body = match.group(1)
        m = re.search(r'^\s*ssid\s*=\s*"((?:\\.|[^"\\])*)"', body, flags=re.M)
        if not m:
            return block
        ssid = _decode_wpa_quoted_ssid(m.group(1))
        if not ssid:
            return block
        priority = WIFI_SELECTED_PRIORITY if ssid == selected_ssid else WIFI_OTHER_PRIORITY
        new_line = f"        priority={priority}"
        if re.search(r'^\s*priority\s*=.*$', body, flags=re.M):
            new_body = re.sub(r'^\s*priority\s*=.*$', new_line, body, count=1, flags=re.M)
        else:
            # Insert before the closing brace while preserving the existing block.
            new_body = body.rstrip() + "\n" + new_line + "\n"
        new_block = "network={" + new_body + "}"
        if new_block != block:
            changed = True
        return new_block

    new_text = re.sub(r'network\s*=\s*\{(.*?)\}', repl, text, flags=re.S)
    return new_text, changed


def write_text_with_sudo(path: str, text: str) -> bool:
    tmp = f"/tmp/fluidardule-{Path(path).name}"
    try:
        Path(tmp).write_text(text, encoding="utf-8")
    except Exception as exc:
        log(f"Wi-Fi temp config write failed: {exc}")
        return False
    code, out = run_cmd(["sudo", "-n", "install", "-m", "600", "-o", "root", "-g", "root", tmp, path])
    try:
        Path(tmp).unlink(missing_ok=True)
    except Exception:
        pass
    if code != 0:
        log(f"Wi-Fi config install failed ({path}): {out}")
        return False
    return True


def set_wifi_priority_for_ssid(ssid: str) -> bool:
    """Raise selected SSID priority in existing config files."""
    ok_any = False
    for path in wifi_conf_paths():
        text = read_wifi_conf_text(path)
        if not text:
            continue
        new_text, changed = update_priorities_in_wpa_text(text, ssid)
        if not changed:
            ok_any = True
            continue
        if write_text_with_sudo(path, new_text):
            ok_any = True
            # Config changed; force the next read to see the new priorities.
            global _wifi_known_ssids_cache_until, _wifi_status_cache_until
            _wifi_known_ssids_cache_until = 0.0
            _wifi_status_cache_until = 0.0
    return ok_any


def wait_for_wifi_connection(ssid: str, timeout_sec: float = 15.0) -> bool:
    """Wait until the selected SSID becomes the active association."""
    deadline = time.time() + float(timeout_sec)
    while time.time() < deadline:
        refresh_wifi_status(force=True)
        if state.wifi_current_ssid == ssid:
            return True
        time.sleep(0.75)
    refresh_wifi_status(force=True)
    return state.wifi_current_ssid == ssid


def connect_wifi_ssid(ssid: str) -> bool:
    """Select Wi-Fi by rewriting priority and restarting OS Wi-Fi services.

    This intentionally avoids wpa_cli select_network because this Fluid Ardule
    image already connects reliably at boot using wpa_supplicant priority, even
    when the wpa_cli control socket is unavailable.
    """
    ssid = str(ssid or "").strip()
    if not ssid:
        return False
    if ssid not in parse_wpa_supplicant_networks(force=True):
        mark_dirty("Wi-Fi network not configured")
        return False

    # Hotfix 2026-05-27:
    # If the selected SSID is already connected, do not rewrite priority or
    # restart Wi-Fi services. A service restart can briefly disturb USB/serial
    # timing on the Raspberry Pi and may make UNO-1 appear disconnected.
    refresh_wifi_status(force=True)
    if state.wifi_enabled and state.wifi_current_ssid == ssid:
        mark_dirty(f"Already connected: {ssid}")
        return True

    if not wifi_is_enabled():
        set_wifi_enabled(True)
        refresh_wifi_status(force=True)
        if state.wifi_enabled and state.wifi_current_ssid == ssid:
            mark_dirty(f"Already connected: {ssid}")
            return True

    if not set_wifi_priority_for_ssid(ssid):
        mark_dirty("Wi-Fi config update failed")
        return False

    show_modal_message("Switching Wi-Fi...", shorten_text(ssid, 24))
    send_ui_status("BUSY", force=True)
    services_ok = restart_wifi_services()
    ok = wait_for_wifi_connection(ssid, timeout_sec=15.0)
    clear_modal_message()
    send_ui_status("READY", force=True)
    if not ok:
        log(f"Wi-Fi priority switch timeout for {ssid}; current={state.wifi_current_ssid or '-'}; services_ok={services_ok}")
    return ok


def wifi_menu_options() -> list[tuple[str, bool]]:
    refresh_wifi_status()
    rows = [(f"Wi-Fi: {'On' if state.wifi_enabled else 'Off'}", state.wifi_enabled)]
    rows.append(("Scan known networks", False))
    if state.wifi_scan_results:
        rows.extend((f"    {ssid}", ssid == state.wifi_current_ssid)
                    for ssid in state.wifi_scan_results)
    else:
        rows.append(("No configured network found", False))
    return rows

# =========================================================
# Raw MIDI discovery
# =========================================================

_RAW_AMIDI_RE = re.compile(r'^(?P<dir>[IO]{1,2})\s+(?P<port>hw:\d+,\d+,\d+)\s+(?P<name>.+?)\s*$')


def list_raw_midi_inputs() -> list[tuple[str, str]]:
    code, out = run_cmd(["amidi", "-l"])
    if code != 0 or not out:
        return []

    entries: list[tuple[str, str]] = []
    for line in out.splitlines():
        line = line.strip()
        if not line or line.lower().startswith("dir"):
            continue
        m = _RAW_AMIDI_RE.match(line)
        if not m:
            continue
        direction = m.group("dir")
        port = m.group("port")
        name = m.group("name").strip()
        if "I" not in direction:
            continue
        entries.append((port, name))
    return entries


def choose_raw_midi_input() -> tuple[str | None, str | None]:
    entries = list_raw_midi_inputs()
    if not entries:
        return None, None

    if RAW_MIDI_DEVICE:
        for port, name in entries:
            if port == RAW_MIDI_DEVICE:
                return port, name
        return RAW_MIDI_DEVICE, RAW_MIDI_DEVICE

    preferred_terms: list[str] = []
    if FIXED_MIDI_SRC:
        preferred_terms.append(FIXED_MIDI_SRC)
    preferred_terms.extend(RAW_MIDI_PREFERRED_HINTS)

    for term in preferred_terms:
        term_lower = term.lower()
        for port, name in entries:
            if term_lower in name.lower() or term_lower in port.lower():
                return port, name

    return entries[0]


def list_raw_midi_outputs() -> list[tuple[str, str]]:
    code, out = run_cmd(["amidi", "-l"])
    if code != 0 or not out:
        return []

    entries: list[tuple[str, str]] = []
    for line in out.splitlines():
        line = line.strip()
        if not line or line.lower().startswith("dir"):
            continue
        m = _RAW_AMIDI_RE.match(line)
        if not m:
            continue
        direction = m.group("dir")
        port = m.group("port")
        name = m.group("name").strip()
        if "O" not in direction:
            continue
        entries.append((port, name))
    return entries


def find_external_midi_raw_output() -> tuple[str | None, str | None]:
    for port, name in list_raw_midi_outputs():
        text = f"{port} {name}".lower()
        if any(hint.lower() in text for hint in EXTERNAL_MIDI_NAME_HINTS):
            return port, name
    return None, None


# =========================================================
# Serial tx helpers
# =========================================================


def send_serial_line(line: str) -> bool:
    global serial_handle, serial_write_error_count
    data = (line.rstrip("\n") + "\n").encode("ascii", errors="ignore")
    with serial_lock:
        if serial_handle is None:
            return False
        try:
            serial_handle.write(data)
            serial_handle.flush()
            serial_write_error_count = 0
            return True
        except Exception as exc:
            serial_write_error_count += 1
            log(f"serial write failed ({serial_write_error_count}/{SERIAL_MAX_CONSEC_WRITE_ERRORS}): {exc}")
            if serial_write_error_count >= SERIAL_MAX_CONSEC_WRITE_ERRORS:
                log("serial write error threshold reached; forcing reconnect")
                try:
                    serial_handle.close()
                except Exception:
                    pass
                serial_handle = None
                serial_write_error_count = 0
            return False


def periodic_serial_heartbeat() -> None:
    global last_serial_hb_time
    now = time.time()
    if now - last_serial_hb_time < SERIAL_HEARTBEAT_INTERVAL_SEC:
        return
    if send_serial_line("HB"):
        last_serial_hb_time = now


def current_ui_link_status() -> str:
    # LINK/HB means the Pi process is alive. UI status means the main loop is
    # intentionally able to accept UNO control events. Keep playback itself
    # READY; reserve BUSY for modal/system operations where input should not be
    # trusted or may be delayed.
    if state.ui_mode == "restart_wait":
        return "BUSY"
    if state.ui_mode == "power_menu" and state.power_confirm_action in {"EXEC_HALT", "EXEC_REBOOT", "EXEC_RESTART_SOFTWARE"}:
        return "BUSY"
    if state.usb_eject_confirm:
        return "BUSY"
    return "READY"


def send_ui_status(status: str, *, force: bool = False) -> bool:
    global last_serial_ui_status_time, last_serial_ui_status_sent
    status = status.strip().upper()
    if status not in {"READY", "BUSY"}:
        status = "READY"
    now = time.time()
    if (not force) and status == last_serial_ui_status_sent and (now - last_serial_ui_status_time) < SERIAL_UI_STATUS_INTERVAL_SEC:
        return False
    if send_serial_line(f"UI:{status}"):
        last_serial_ui_status_sent = status
        last_serial_ui_status_time = now
        return True
    return False


def periodic_serial_ui_status() -> None:
    send_ui_status(current_ui_link_status())


def encoder_accel_context_key() -> str:
    """Return a compact key for Pi-selected encoder acceleration policy."""
    if state.ui_mode == "submenu":
        return f"submenu:{state.submenu_key or ''}"
    return str(state.ui_mode or "main")


def desired_encoder_accel_profile() -> int:
    """Choose the default encoder acceleration profile for the current UI."""
    key = encoder_accel_context_key()
    profile = UI_ACCEL_PROFILE_BY_CONTEXT.get(key, UI_ACCEL_PROFILE_DEFAULT)
    try:
        return max(0, min(3, int(profile)))
    except Exception:
        return UI_ACCEL_PROFILE_DEFAULT


def sync_encoder_accel_profile(*, force: bool = False, reason: str = "") -> None:
    """Send the UI-context-specific acceleration profile to UNO-1.

    UNO-1 owns the low-level encoder acceleration and displays the active
    P0/P1/P2/P3 profile on its LCD.  The Pi only selects the desired profile
    for the current UI context and sends ACCELSET:n when the context changes
    or after serial reconnect.
    """
    global last_accel_context_key, last_sent_accel_profile
    if serial_handle is None:
        return
    key = encoder_accel_context_key()
    profile = desired_encoder_accel_profile()
    if (not force) and key == last_accel_context_key and profile == last_sent_accel_profile:
        return
    if send_serial_line(f"ACCELSET:{profile}"):
        last_accel_context_key = key
        last_sent_accel_profile = profile
        state.encoder_accel_profile = profile
        state.encoder_accel_pending_profile = profile
        if ACCEL_PROFILE_TRACE:
            suffix = f" reason={reason}" if reason else ""
            log(f"ACCEL_PROFILE ui={key} -> P{profile}{suffix}")


def request_startup_pot_snapshot_window() -> None:
    """Ask UNO-1 to report the physical POT position soon after serial opens.

    This keeps startup volume owned by the knob, not by the saved/default
    fallback.  Older UNO firmware may ignore REQ:POT; in that case this is
    harmless, and normal POT movement still works.
    """
    now = time.time()
    state.pot_startup_request_until = now + POT_STARTUP_SNAPSHOT_REQUEST_SEC
    state.last_pot_startup_request_time = 0.0


def periodic_startup_pot_snapshot_request() -> None:
    if state.initial_pot_volume_applied:
        return
    now = time.time()
    if now > state.pot_startup_request_until:
        return
    if now - state.last_pot_startup_request_time < POT_STARTUP_SNAPSHOT_REQUEST_INTERVAL_SEC:
        return
    state.last_pot_startup_request_time = now
    send_serial_line("REQ:POT")


def ack_uno_event(kind: str) -> None:
    kind = kind.strip().upper()
    if kind in {"BTN", "ENC"}:
        send_serial_line(f"ACK:{kind}")


def pulse_midi_led() -> None:
    send_serial_line("ACT:MIDI")


def maybe_pulse_led(min_interval_sec: float = LED_PULSE_COOLDOWN_SEC, *, force: bool = False) -> None:
    now = time.time()
    if (not force) and (now - state.last_led_pulse_time) < min_interval_sec:
        return
    state.last_led_pulse_time = now
    pulse_midi_led()


def maybe_pulse_pot_led(current_percent: int) -> None:
    now = time.time()
    if state.last_pot_led_percent < 0:
        state.last_pot_led_percent = current_percent
        return
    if abs(current_percent - state.last_pot_led_percent) < POT_LED_PERCENT_THRESHOLD:
        return
    if (now - state.last_pot_led_pulse_time) < POT_LED_PULSE_INTERVAL_SEC:
        return
    state.last_pot_led_pulse_time = now
    state.last_pot_led_percent = current_percent


def set_play_led(mode: str) -> None:
    mode = mode.strip().upper()
    if mode not in {"OFF", "ON", "BLINK"}:
        return
    send_serial_line(f"PLAY:{mode}")


def notify_uno_power_state(action: str) -> None:
    """Notify UNO-1 before a UI-initiated power action.

    This is intentionally used only from the Fluid Ardule power menu.
    SSH/systemd/manual poweroff paths are not treated as safe-unplug events
    on UNO-1 because they may be indistinguishable from cable removal or
    firmware-upload replug scenarios.
    """
    action = action.strip().upper()
    if action == "HALT":
        send_serial_line("PWR:SHUTDOWN")
    elif action == "REBOOT":
        send_serial_line("PWR:REBOOT")


def pulse_button_activity() -> None:
    # MIDI LED is reserved for actual incoming MIDI note activity.
    return



# =========================================================
# MIDI activity monitor (actual incoming note events)
# =========================================================

def get_midi_activity_monitor_spec() -> tuple[list[str] | None, str]:
    if not MIDI_ACTIVITY_MONITOR_ENABLED:
        return None, ""

    # RAW MIDI is intentionally not monitored for Tap Tempo. FluidSynth owns
    # the RAW device directly, and taking it over through amidi caused perceptible
    # feedback latency. SEQ-style inputs can be observed with aseqdump. During
    # Tap Tempo the direct aconnect route is disconnected, so the observed key
    # does not also reach FluidSynth as a piano note.
    if state.midi_mode in {"alsa_midi", "uno2_bridge_seq", "external_midi_seq"}:
        port = state.midi_src_port
        if port and port not in {"-", "", "seq"}:
            return ["aseqdump", "-p", port], f"seq:{port}"
        return None, ""
    return None, ""


def stop_midi_activity_monitor() -> None:
    global midi_activity_proc, midi_activity_signature
    proc = midi_activity_proc
    midi_activity_proc = None
    midi_activity_signature = ""
    if proc is None:
        return
    try:
        if proc.poll() is None:
            os.killpg(os.getpgid(proc.pid), signal.SIGTERM)
            time.sleep(0.2)
            if proc.poll() is None:
                os.killpg(os.getpgid(proc.pid), signal.SIGKILL)
    except Exception:
        pass


def start_midi_activity_monitor_if_needed() -> None:
    global midi_activity_proc, midi_activity_signature
    cmd, signature = get_midi_activity_monitor_spec()

    if not cmd:
        if midi_activity_proc is not None:
            stop_midi_activity_monitor()
        return

    if midi_activity_proc is not None and midi_activity_signature == signature and midi_activity_proc.poll() is None:
        return

    stop_midi_activity_monitor()
    try:
        midi_activity_proc = subprocess.Popen(
            cmd,
            stdout=subprocess.PIPE,
            stderr=subprocess.DEVNULL,
            text=True,
            bufsize=1,
            preexec_fn=os.setsid,
        )
        midi_activity_signature = signature
    except Exception as exc:
        midi_activity_proc = None
        midi_activity_signature = ""


def midi_activity_line_has_note_on(line: str) -> bool:
    s = (line or "").strip()
    if not s:
        return False

    low = s.lower()
    # aseqdump output
    if "note on" in low:
        if "velocity 0" in low:
            return False
        return True

    # amidi -d style hexadecimal byte dump
    tokens = re.findall(r'\b[0-9A-Fa-f]{2}\b', s)
    if len(tokens) < 3:
        return False
    try:
        data = [int(tok, 16) for tok in tokens]
    except Exception:
        return False

    i = 0
    running_status = None
    while i < len(data):
        b = data[i]
        if b & 0x80:
            running_status = b
            i += 1
            if 0x80 <= b <= 0xEF:
                status_nibble = b & 0xF0
                needed = 1 if status_nibble in (0xC0, 0xD0) else 2
                if i + needed - 1 >= len(data):
                    break
                d1 = data[i]
                d2 = data[i + 1] if needed > 1 else 0
                if status_nibble == 0x90 and d2 > 0:
                    return True
                i += needed
            else:
                continue
        else:
            if running_status is None:
                i += 1
                continue
            status_nibble = running_status & 0xF0
            needed = 1 if status_nibble in (0xC0, 0xD0) else 2
            if i + needed - 1 >= len(data):
                break
            d1 = data[i]
            d2 = data[i + 1] if needed > 1 else 0
            if status_nibble == 0x90 and d2 > 0:
                return True
            i += needed

    return False


def midi_activity_monitor_thread() -> None:
    global midi_activity_proc, midi_activity_signature
    while state.running:
        try:
            start_midi_activity_monitor_if_needed()
            proc = midi_activity_proc
            if proc is None or proc.stdout is None:
                time.sleep(MIDI_ACTIVITY_MONITOR_POLL_SEC)
                continue

            line = proc.stdout.readline()
            if not line:
                if proc.poll() is not None:
                    midi_activity_proc = None
                    midi_activity_signature = ""
                time.sleep(0.05)
                continue

            if midi_activity_line_has_note_on(line):
                if state.ui_mode == "adp_tap_tempo":
                    register_adp_tap()
                maybe_pulse_led()

        except Exception as exc:
            stop_midi_activity_monitor()
            time.sleep(MIDI_ACTIVITY_MONITOR_POLL_SEC)

# =========================================================
# TFT display
# =========================================================
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
