jeong0449/FluidArdule/(commit log)

2026-04-19 MIDI LED pulse tuning (300ms → 70ms)
2026-04-20 Add real-time button debug display on LCD (SP/LP)
    Add real-time button debug display on LCD (short/long press)
    - Display last button event on right side of LCD line 1 (6 chars)
    - Distinguish short press (SP) and long press (LP)
    - Show debug tag immediately at detection time (not on release)
    - Update tag in-place when long press threshold is reached
    - Do not change existing input or MIDI behavior
    - Intended for debugging input misinterpretation between UNO and Pi
    This helps quickly verify whether button events are correctly
    detected and transmitted, especially when diagnosing mismatches
    such as LEFT being interpreted as UP on the Pi side.
    [uno1_input_controller.ino]
2026-04-20 Add 20ms debounce to encoder input
    Add lightweight 20ms debounce filter to encoder input handling in Python layer.
    - Introduced time-based filtering at handle_encoder_value() entry point
    - Prevents spurious UP/DOWN events caused by encoder noise
    - Keeps existing event pipeline intact (no behavioral changes elsewhere)
    - Safer than firmware-level change for quick stabilization
    This helps reduce unintended navigation actions (e.g., LEFT misfire or track skip)
    observed during file playback.
    [launch_fluidardule.py]
2026-04-22 docs: refine installation guide and add pre-service configuration
    docs: refine installation guide and add pre-service configuration
    - add Pre-Service Configuration section
    - document USB DAC and MIDI device identification
    - explain name-based device matching (avoid dynamic indices)
    - improve structure and readability of installation steps
    - polish wording and consistency
2026-04-23 Add information on PCM5102A DAC board
2026-04-24 Fix keypad button thresholds
    [uno1-hardware-test-i2c1602.ino, uno1-input-controller.ino]
2026-04-24 No rollover, safe reconnect
    Improve playback stability and user experience
    - Disable rollover navigation:
    * Stop at first/last item when browsing (no wrap-around)
    * Stop playback at end of folder instead of looping
    - Prevent unintended input:
    * Ignore encoder rotation during playback to avoid accidental track changes
    * Add input suppression window after UNO reconnection to avoid spurious events
    - Improve system safety:
    * Handle USB eject (LEFT_LP) globally when not playing
    * Block eject menu when no USB device is mounted
    These changes make the player behavior more predictable and robust,
    especially in live playback scenarios and during hardware reconnect events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
    [launch_fluidardule.py]
2026-04-24 Add Yoshimi engine and patch preview
    Add Yoshimi engine integration
    - Add Yoshimi as a selectable synth engine
    - Load Yoshimi patches from JSON v2 patch metadata
    - Support bank-to-instrument browsing
    - Read nested yoshimi.patch_path entries correctly
    - Start Yoshimi with selected .xiz patches
    - Restore the selected Yoshimi patch after media playback
    [launch_fluidardule.py]
2026-04-25 Fix pot noise and input LED behavior
    Improve input LED stability and pot noise handling
    - Separate pot thresholds for control and LED:
    * POT_DELTA_SEND for smooth value transmission
    * POT_DELTA_LED to suppress noise-triggered LED hold
    - Fix issue where D11 LED stayed ON due to analog noise when connected to Pi
    - Add input activity LED behavior:
    * Encoder and pot keep LED ON while active
    * Button short press = 1 blink
    * Button long press = 2 blinks
    - Preserve MIDI activity LED pulse from Pi (ACT:MIDI)
    This improves reliability and makes UNO-1 usable as a standalone input tester.
    [uno1-input-controller.ino]
2026-04-25 Fix USB boot behavior (no auto File Player entry)
    Fix unintended UI transition on boot when USB is already mounted.
    Previously, the system treated a pre-mounted USB device as a runtime insertion event,
    causing an automatic transition to File Player > Source selection screen.
    This resulted in an unexpected splash-like redraw and disrupted the home screen flow.
    This patch removes automatic UI navigation from USB mount detection.
    USB events now update state only, without forcing screen transitions.
    UX principle enforced:
    "USB events change state, not screen."
    [launch_fluidardule.py]
2026-04-25 Refine UI: Quick Menu, header policy, layout
    Refine UI structure and interaction model for Fluid Ardule.
    - Implement Quick Menu (RIGHT long press) with Resume, Now Playing, Home,
    Sound Source, USB Eject, and Power options
    - Separate Resume (navigation context) and Now Playing (runtime state)
    - Restrict "Fluid Ardule" header to Home screen only
    - Remove header from menus, player, and Quick Menu to increase information density
    - Adjust layout to reclaim header space and display full menu items without scrolling
    - Maintain rendering stability (no additional redraw load or regressions)
    - Preserve existing input behavior and system functionality
    [launch_fluidardule.py]
2026-04-25 Fix Sound Source auto-return after apply
    Fix missing auto-return behavior in Sound Source menu.
    Previously, selecting a Sound Source applied the change but did not
    return to the parent menu, breaking UI consistency.
    This patch aligns Sound Source behavior with MIDI Mode:
    SELECT now applies the change and immediately returns.
    No changes to existing functionality or input handling.
    [launch_fluidardule.py]
2026-04-25 Fix Sound Source return and silence Yoshimi log
    Improve UI consistency and suppress Yoshimi console noise.
    - Fix Sound Source menu to return automatically after selection,
    aligning with the established “SELECT = apply + return” rule
    - Suppress repetitive Yoshimi CLI prompt output ("@ Top")
    by running Yoshimi in non-interactive/silent mode
    - Preserve playback, patch handling, and all existing behaviors
    - No changes to input handling or system stability
    [launch_fluidardule.py]
2026-04-26 Stabilize A0 keypad input with averaging filter
    Stabilize A0 keypad input using lightweight averaging and debounce alignment.
    - Apply 4-sample averaging to analog A0 readings before decoding
    - Preserve existing debounce timing (DEBOUNCE_MS) for stable state transitions
    - Adjust thresholds based on measured button values for improved robustness
    - Reduce noise-induced misclassification (e.g., UP detected as LEFT)
    - No changes to encoder, LED, POT, or Pi communication logic
    [uno1-input-controller.ino]
2026-04-27 Add encoder long-press accel switching with LCD
    Add encoder long-press to cycle acceleration profiles (P1–P3)
    - Implement encoder long-press to switch accel profile (P1 → P2 → P3 → P1)
    - Send ACCEL:<n> message to host on profile change
    - Display current accel profile on 1602 LCD (e.g., "ENC ACCEL / P2 NORM")
2026-04-27 Add complete Sound Edit system with POT control
    Implement full Sound Edit workflow with POT control and pickup
    - Introduce complete Sound Edit system for real-time CC parameter editing
    - Add POT mode toggle (VOL ↔ PARAM) via LEFT long press
    - Implement soft takeover (pickup) to prevent volume jumps when returning to VOL mode
    - Apply encoder acceleration only to value editing, keeping menu navigation stable
    - Add visual feedback for modified values in Sound Edit (highlighted state)
    - Display accel and POT mode changes in footer with timed hold
    - Enable MIDI panic (DOWN long) within Sound Edit context
    - Ensure preset change re-applies full CC set for consistent sound state
    [launch_fluidardule.py]
2026-04-27 Show accel profile (P1–P3) on LCD footer
    Display encoder acceleration profile (P1–P3) on 1602 LCD footer
    - Show current accel profile (P1, P2, P3) at right end of bottom row
    - Preserve existing status message area (left side, up to 13 chars)
    - Ensure profile indicator is always visible during normal operation
    - Keep UI minimal and consistent with constrained 1602 layout
    - Minor cleanup of POT delta naming for clarity
2026-04-28 stabilize safe unplug timing and power-off display
    [uno1-input-controller.ino]
2026-05-01 Restore folder cursor on parent navigation
    Improve file browser UX by restoring the previously selected folder
    position when navigating back to the parent directory instead of
    resetting to the first item
    [launch_fluidardule.py]
2026-05-02 Delay ACK by 300ms for input visibility
    Improve LCD debug UX by delaying ACK display after input events.
    Previously, ACK-B/ACK-E messages immediately overwrote button/encoder
    feedback on the LCD, making it difficult to see user input.
    This update introduces a 300ms delay to preserve the input event
    display before showing ACK responses, resulting in clearer and more
    intuitive visual feedback without altering any core functionality.
2026-05-03 Add USB MIDI cable support with stable routing
    USB MIDI Cable Integration and Routing Stability Improvements
    - Add full support for USB MIDI cable as both ALSA SEQ input and external MIDI output (mirror mode)
    - Enable DIN keyboard and external sound module integration via a single USB MIDI interface
    - Allow direct selection of active ALSA MIDI devices in MIDI Mode (no submenu)
    - Display only currently connected MIDI inputs at menu entry
    - Filter out non-user ALSA ports (aseqdump, Midi Through, System) from MIDI Mode
    - Hide External MIDI OUT in RAW mode and restrict mirror functionality to SEQ-based inputs
    - Reset MIDI mode to RAW on device removal for predictable behavior
    - Improve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
    [launch_fluidardule.py]
2026-05-03 Fix external MIDI stuck notes on stop/pause
    [launch_fluidardule.py]
2026-05-04 Fix encoder jitter & direction; restore LCD event line
    Refactor rotary encoder handling for stability and accuracy.
    - Replaced edge-based detection with state transition decoding to eliminate occasional reverse-step jitter
    - Corrected encoder direction mapping to match physical rotation
    - Preserved acceleration behavior and event reporting logic
    [uno1-input-controller.ino]
2026-05-04 Clean test UI & fix encoder handling
    Refined hardware test firmware for clarity and reliability.
    - Replaced ambiguous LCD indicators (B:---, S:1, ST, etc.)
    with a simplified UI:
    - Line 1: event-based messages (ENC, BTN SHORT/LONG, KEY)
    - Line 2: persistent state (POT, encoder value, gain)
    - Applied stable rotary encoder decoding using
    state transition method to eliminate jitter and
    occasional reverse-step errors
    - Integrated encoder button into event display for
    consistent input visibility
    All other test behaviors (buttons, POT, LED, I2C LCD)
    remain unchanged.
    [uno1-hardware-test-i2c1602.ino]
2026-05-04 Fix encoder jitter & direction
    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
    [uno1-hardware-test-i2c1602.ino, uno1-input-controller.ino]
2026-05-23 Add keypad self-calibration system
    Add intelligent keypad calibration and runtime safety
2026-05-24 Fix calibration auto-advance bug
    Hotfix calibration auto-skip caused by release noise
    [uno1-input-controller.ino]
2026-05-26 Improve UNO-1 calibration reliability
    Improve UNO-1 calibration reliability and EEPROM fallback handling
    - Fixed calibration step progression after capturing button values
    - Removed EEPROM-based key validation during calibration
    - Allowed calibration to proceed even with incorrect stored ADC values
    - Reduced false key detection caused by encoder long-press release noise
    - Preserved ADC stabilization delay and multi-sample averaging
    - Improved EEPROM save/exit calibration flow
    - Reduced unnecessary "Hold exact key" calibration failures
    [uno1-input-controller.ino]
2026-05-26 Add Internet Radio and favorites support
    Add Internet Radio playback and favorites support
    - Added Internet Radio source to Media Player
    - Added mpv-based streaming playback support
    - Added curated default radio station list including SomaFM streams
    - Added radio_stations.json and persistent radio_favorites.json support
    - Added Favorites browser inside Internet Radio
    - Added RIGHT-button favorite toggle during radio playback
    - Fixed LEFT navigation returning from radio player to radio browser
    - Added radio player state handling separate from file playback
    - Renamed File Player menu to Media Player
    - Added lazy radio JSON initialization to preserve startup stability
    - Improved ra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
    [launch_fluidardule.py]
2026-05-27 Add Wi-Fi selector using priority switching
    Add lightweight Wi-Fi selection support to Fluid Ardule.
    Implemented a minimal Wi-Fi management UI under:
    Home → Extension → Wi-Fi
    Features:
    - Wi-Fi ON/OFF
    - Scan known networks
    - Select among currently visible configured SSIDs
    Instead of relying on unstable direct wpa_cli control,
    the selector now updates network priority values in the
    active wpa_supplicant configuration and restarts the
    Wi-Fi service to allow Raspberry Pi OS to reconnect
    normally.
    This approach proved more robust for the current
    headless/systemd-based Fluid Ardule environment using:
    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
    [launch_fluidardule.py]
2026-05-27 Fix Wi-Fi selector permission handling
    Fix Wi-Fi selector permission and reconnect handling.
    The previous Wi-Fi selector implementation attempted to read
    wpa_supplicant configuration files directly from Python.
    On the current Raspberry Pi OS setup, the active configuration:
    /etc/wpa_supplicant/wpa_supplicant-wlan0.conf
    is protected with root-only permissions (600), causing:
    Permission denied
    errors during Wi-Fi selection.
    This prevented reliable detection of configured SSIDs and
    current connection state, which could trigger unnecessary
    Wi-Fi service restarts and occasional UNO serial reconnects.
    Changes:
    - Use wlan0-specific config as authoritative source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
    [launch_fluidardule.py]
2026-05-28 Reduce UNO-1 auto-reset on reconnect
    Suppress unintended UNO-1 reset during serial reconnect
    [launch_fluidardule.py]
2026-05-29 Reinitialize LCD on first Pi link
    Add LCD reinitialization on first Pi HELLO link establishment
    - Reinitialize LCD controller after first successful HELLO
    - Improve LCD recovery after startup and service restart
    - Reduce occurrence of garbled LCD characters
    - Complement RESET-GND startup stabilization capacitor
    [uno1-input-controller.ino]
2026-05-29 Document 10uF reset capacitor as primary fix
2026-05-29 Restore POT deadband filtering
2026-05-31 Refine power menu and add software restart
2026-05-31 Improve encoder direction reversal responsiveness
    [uno1-input-controller.ino]
2026-06-03 Show all 6 Home items and fix Combi focus
    [launch_fluidardule.py]
2026-06-16 Improve controller responsiveness with ISR
    - Replace polling encoder with interrupt-driven handling.
    - Eliminate missed encoder steps during fast rotation.
    - Tune encoder transition scaling.
    - Reduce button debounce latency.
    - Improve overall controller responsiveness.
    [uno1-input-controller.ino]
2026-06-16 Improve UI responsiveness for encoder
    - Preserve full ENC delta during menu navigation.
    - Remove legacy navigation debounce filtering.
    - Improve fast encoder navigation.
    - Keep TFT rendering throttled for audio stability.
    [launch_fluidardule.py]
2026-06-21 Add framebuffer screenshot utility
2026-06-21 Event-driven UI greatly reduces CPU usage
    Redesign UI rendering around an event-driven model.
    Replace periodic screen updates with redraws triggered by
    user interaction, dramatically reducing Python CPU usage
    during playback and live performance.
    Highlights
    - Remove continuous TFT redraws
    - Refresh status on demand (UP long)
    - Introduce event-driven screen updates
    - Improve Yoshimi playback stability
    - Reduce audio glitches during performance
    - Lower Python CPU utilization significantly
    - Optimize Combi rendering
    - Add framebuffer screenshot utility
    - Improve Sound Source button consistency
    [launch_fluidardule.py]
2026-06-27 Improve USB hotplug and startup volume UX
    Improve USB hotplug responsiveness and startup volume UX
    - Restore USB storage plug-and-play detection without sacrificing
    the event-driven rendering architecture.
    - Keep USB mount monitoring lightweight and independent of manual
    status refresh.
    - Use a fixed startup output level (85%) for predictable startup behavior.
    - Apply soft takeover (±3%) before the hardware volume knob becomes active,
    preventing abrupt volume jumps.
    - Notify successful volume synchronization with a centered popup
    ("Volume Active") instead of a footer message.
    - Preserve low CPU usage while improving overall user experience.
    [launch_fluidardule.py]
2026-06-27 Improve Combi workflow consistency
    Improve Combi workflow consistency
    - Make RIGHT the consistent entry action for the Combi browser.
    - Clarify SELECT behavior with context-sensitive modal guidance.
    - Unify bottom status bar button hints in the Sound menu.
    - Restrict Quick Menu access while browsing or using Combi,
    encouraging predictable LEFT-button navigation.
    - Preserve loaded Combi sounds while simplifying workflow.
2026-06-27 Improve Combi navigation and preset preview
    Improve Combi navigation and User Preset preview
    - Make Combi entry consistent with RIGHT-button navigation.
    - Add contextual guidance for SELECT on Combi.
    - Refine Sound menu button hints for consistency.
    - Restrict Quick Menu while Combi workflow is active.
    - Apply debounced preview consistently to User Presets,
    including rotary encoder navigation.
2026-06-28 Refine preset browsing and UI consistency
    Refine preset browsing and overall UI consistency
    - Add page-based navigation for selection lists.
    - Keep the last previewed sound when returning to preset categories.
    - Make SELECT the primary action button across the UI.
    - Reduce list visual clutter by showing navigation markers only on the highlighted item.
    - Improve User Preset preview behavior and responsiveness.
2026-06-29 Improve UI stability and recovery workflow
    Improve stability, UI consistency, and recovery workflow
    - Refine Yoshimi/FluidSynth lifecycle handling
    - Move User Preset Manage to LEFT long press
    - Replace DOWN long press with Refresh Current Sound
    - Move MIDI Panic to Quick Menu
    - Improve list redraw to reduce TFT highlight artifacts
    [launch_fluidardule.py]
2026-07-01 Improve Yoshimi transition and reload UX
    Improve Yoshimi transition and loading UX
    - Keep current screen after DOWN long-press refresh
    - Show loading modal consistently during SoundFont/Yoshimi reload
    - Reduce Yoshimi restart noise using brief output attenuation
    [launch_fluidardule.py]
2026-07-02 Implement context-aware encoder acceleration
    Implement context-specific encoder acceleration profiles and clean up legacy input handling
    - Add context-aware encoder acceleration (P0–P3)
    - Introduce ACCELSET:0–3 protocol (Pi → UNO-1)
    - Automatically synchronize encoder profile on UI changes and UNO reconnect
    - Add optional encoder and acceleration trace diagnostics
    - Reserve P3 for manual turbo override
    - Remove obsolete long-press handlers and unreachable code
    - Eliminate duplicate global declarations
    - Update protocol documentation
2026-07-02 Implement live Yoshimi instrument loading
    Implement live Yoshimi instrument loading
    - Replace restart-based instrument switching with live "load instrument"
    - Control Yoshimi through a persistent stdin channel
    - Support symlink-based instrument paths
    - Preserve automatic restart fallback
    - Remove obsolete transition mute workaround
    - Remove temporary volume ducking during instrument changes
    - Simplify Yoshimi loading workflow
    - Remove redundant Loading Default modal
    [launch_fluidardule.py]
2026-07-03 Improve radio controls and add Arpeggio Speed
    Improve radio playback controls and add calibrated Yoshimi Arpeggio Speed
    Add UP/DOWN station switching during internet radio playback and update
    the Now Playing footer to show PREV/NEXT controls consistently. Improve
    playback stop handling so the internal sound source is restored
    immediately after radio or media playback.
    Expand the Home Extension item into a submenu and move the existing
    Wi-Fi function under it. Add SEL to Expand guidance for clearer menu
    navigation.
    Add live Arpeggio Speed control for supported Yoshimi Arpeggios presets.
    Expose the control through both the Extension submenu and Quick Menu,
    and display the curre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
2026-07-06 Improve sound transition consistency
    Improve Sound selection and transition consistency across SoundFont presets, User Presets, and Combis. Refine preview and commit behavior to avoid unnecessary duplicate loading, improve loading modal handling and startup settling for large SoundFonts, and preserve symbolic-link paths for smooth Yoshimi patch live loading.
    [launch_fluidardule.py]
2026-07-07 Improve Combi locking, loading, and recovery
    Improve Combi locking, loading, and recovery
    - Treat state.combi_active as a persistent performance lock
    - Keep the active Combi sounding when returning to the Sound menu
    - Release Combi only after explicitly loading another sound
    - Block Home and normal Quick menu access while Combi is active
    - Show a Combi active notice when attempting to leave Sound
    - Switch to ALSA sequencer mode before loading Combi SoundFonts
    - Avoid redundant RAW-to-SEQ FluidSynth restarts during Combi loading
    - Reduce initial Combi load time from about 8.3 s to about 3.7 s
    - Prevent stale Combi router threads from restarting
    - Separate lightweight MIDI Panic fr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
    [launch_fluidardule.py]
2026-07-08 Fix stale LINK LOST display after relink
    [uno1-input-controller.ino]
2026-07-09 refactor: simplify power menu UI
2026-07-12 Restore ACCELSET-based encoder profile switching
    Restore ACCELSET support for menu-specific encoder profiles
    - Re-enable ACCELSET command handling from Raspberry Pi
    - Restore P0-P3 profile switching
    - Implement P0 as no acceleration
    - Update LCD profile display immediately after ACCELSET
2026-07-12 Fix Yoshimi live-load path selection
    Restore reliable Yoshimi live-load path resolution
    Compare Yoshimi implementations from 260702f through 260710e,
    restore the stable path-selection logic, prefer space-free local
    instrument paths, and keep restart fallback only when live loading
    cannot be used. Also return the Yoshimi CLI to the root context
    before issuing live instrument load commands.
    [launch_fluidardule.py]
2026-07-19 Integrate Bluetooth Audio into Media Player
    Integrate Bluetooth Audio into Media Player.
    Adds an integrated Bluetooth Audio mode using BlueALSA with
    automatic engine suspension and restoration. The Media Player
    can now receive A2DP audio from paired devices while preserving
    Fluid Ardule's instrument-oriented workflow.
    Also updates the installation and Bluetooth documentation to
    reflect the new official feature.
2026-07-23 Improve Combi and Media Player workflows
    Improve Combi and Media Player workflows
    - Add Arachno GM to the available SoundFont sources.
    - Show the Wi-Fi IPv4 address with the connected SSID.
    - Add SoundFont-specific Combi files for FluidR3 GM,
    GeneralUser GS, and Arachno GM.
    - Allow RIGHT to select the target Combi SoundFont and
    SELECT to load or reopen the selected Combi.
    - Keep the active Combi marked across list and detail views.
    - Return from Combi detail to the Combi list with LEFT.
    - Allow LEFT long press in the Combi list to escape by
    loading Salamander C5 Lite.
    - Prevent global Combi-lock actions from interfering with
    the active Combi workflow.
    - Show the active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
    [launch_fluidardule.py]
2026-08-13 Reverse drum pattern thumbnail rows
    [launch_fluidardule.py]
2026-09-10 Improve sound workflow and UI responsiveness
    Refine Fluid Ardule sound architecture and UI responsiveness
    - load Salamander piano and a resident general SoundFont together
    - use Arachno as the default general SoundFont with FluidR3 selectable
    - make MIDI playback follow the currently selected general SoundFont
    - implement reliable exclusive handoff between FluidSynth and Yoshimi
    - make Combi definitions SoundFont-independent
    - use the resident general SoundFont for Combi playback
    - add fast Combi-to-Combi switching without engine or SoundFont reload
    - load Combis immediately while browsing and show parts with SEL
    - keep Combi active as a persistent performance state across UI navi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
2026-09-11 Improve Sound submenu interaction and status
    Improve Sound submenu interaction and status display
    - add Default/Preset quick-selection workflow
    - switch choices with RIGHT while keeping selection field fixed
    - use SELECT consistently to execute the active choice
    - simplify preset count display and remove row chevrons
    - show context-aware Sound status for Yoshimi and Combi
    - refine Sound submenu visual feedback
    [launch_fluidardule.py]
2026-09-12 Improve Wi-Fi SSID detection and scan robustness
    - preserve existing FluidSynth and resident SoundFont architecture
    - merge configured SSIDs from available wpa_supplicant configs
    - handle UTF-8 SSIDs without unicode_escape corruption
    - add iw fallback for current SSID detection
    - try iw, iwlist, and wpa_cli for network scanning
    - retain the currently connected SSID when active scan fails
    - add scan timeout to prevent UI blocking
    [launch_fluidardule.py]
2026-09-20 Improve drum controls and volume handling
    Improve drum controls and volume handling
    - Fix Quick Menu Home navigation while Combi is active
    - Standardize menu and Quick Menu navigation markers
    - Rename Play with Drums controls to Focus, Previous, and Next
    - Add POT-controlled drum volume with VOL/DRM mode switching
    - Apply soft takeover to both master and drum volume
    - Show VOL/DRM and percentage during volume adjustment
    - Restore POT to master volume when leaving Play with Drums
    [launch_fluidardule.py]
